OpenKNX/LED-UP1-6x24V/dev_doc/Pictures/IMG_20210327_100527976.jpg

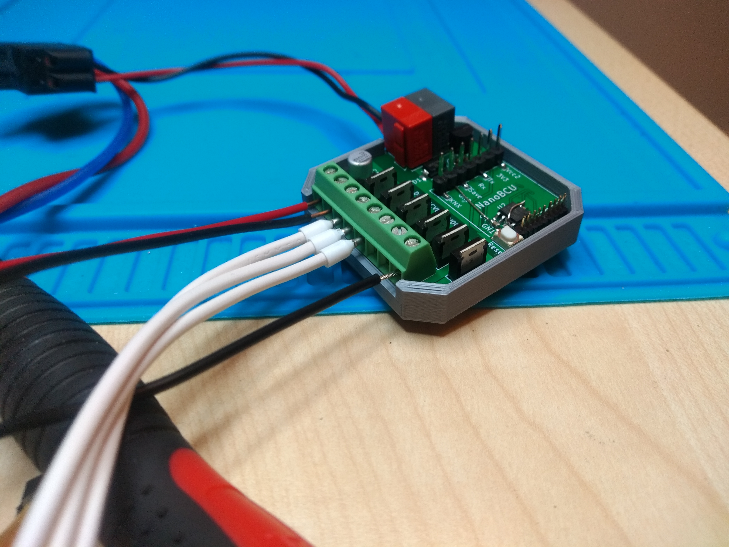
dev_doc/Pictures/IMG_20210327_100527976.jpg
