OpenKNX/LED-UP1-6x24V/dev_doc/Pictures/IMG_20210327_111949214.jpg

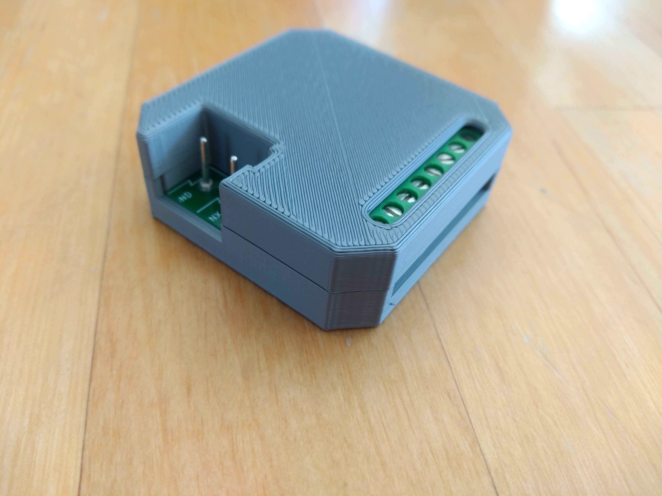
dev_doc/Pictures/IMG_20210327_111949214.jpg
