OpenKNX/LED-UP1-6x24V/README.md

# LED-UP1-6x24V
OpenKNX 6channel LED PWM Controller up to 24V

see https://github.com/OpenKNX/OpenKNX/wiki/LED-UP1-6x24V
