OpenKNX/LED-UP1-6x24V/dev_doc/2022-01-28 14_53_08-3D Viewer.png

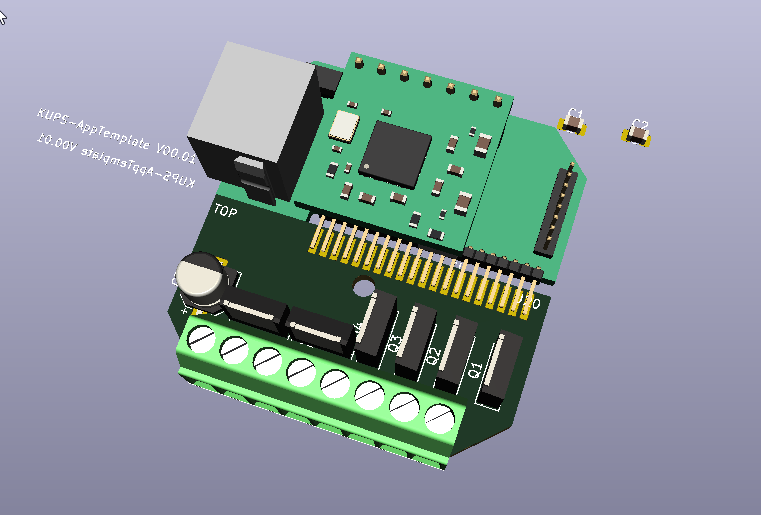
dev_doc/2022-01-28 14_53_08-3D Viewer.png
