OpenKNX/LED-UP1-6x24V/dev_doc/2022-01-29 09_12_00-3D Viewer.png

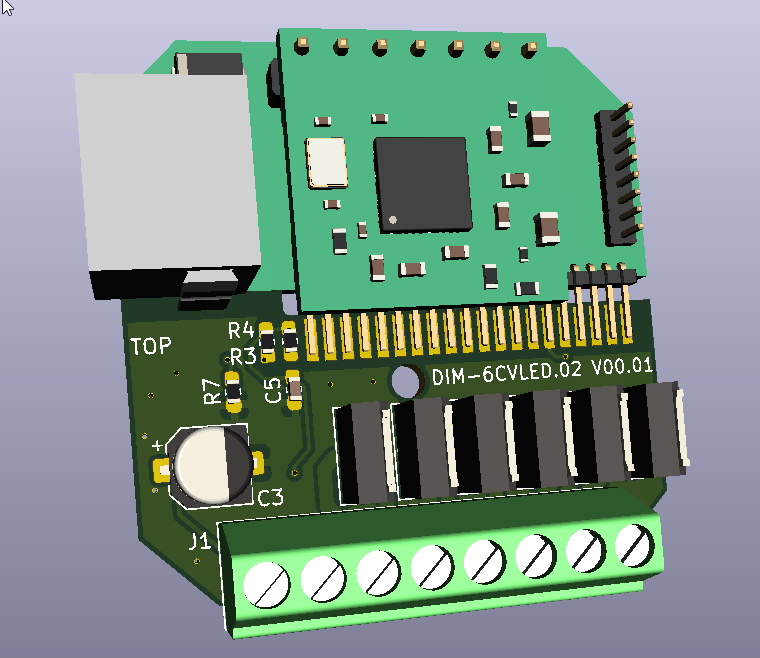
dev_doc/2022-01-29 09_12_00-3D Viewer.png
