OpenKNX/LED-UP1-6x24V/dev_doc/Pictures/IMG_20210327_100537087.jpg

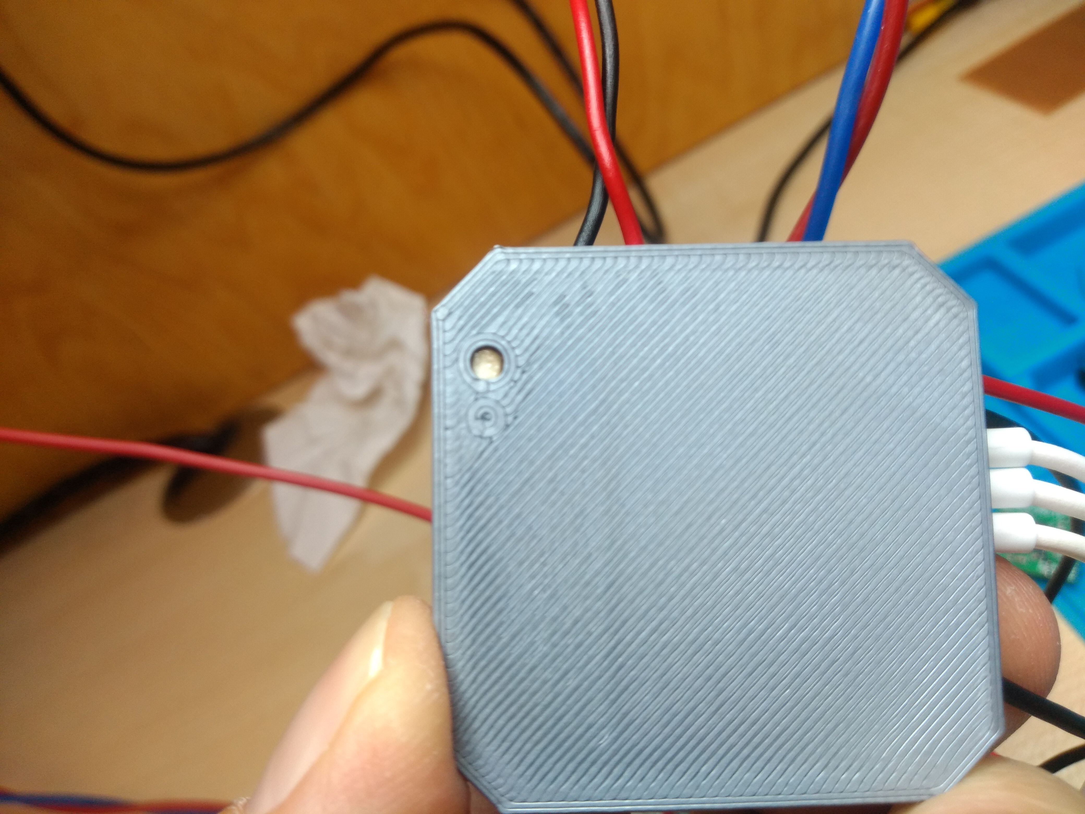
dev_doc/Pictures/IMG_20210327_100537087.jpg
