OpenKNX/LED-UP1-6x24V/dev_doc/Pictures/IMG_20210327_112004446.jpg

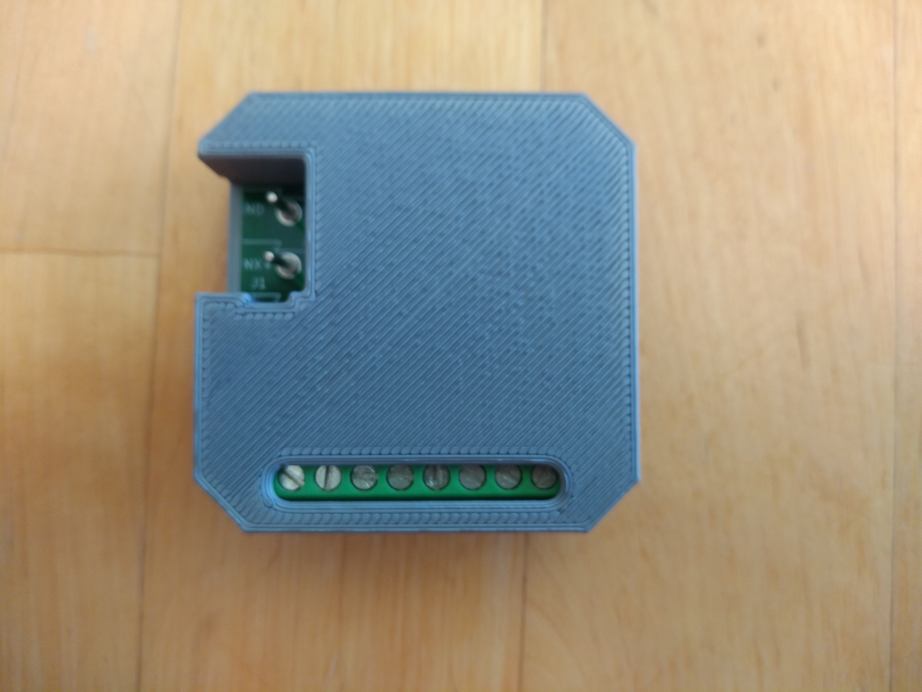
dev_doc/Pictures/IMG_20210327_112004446.jpg
