OpenKNX/LED-UP1-6x24V/dev_doc/Pictures/IMG_20210409_113622945.jpg

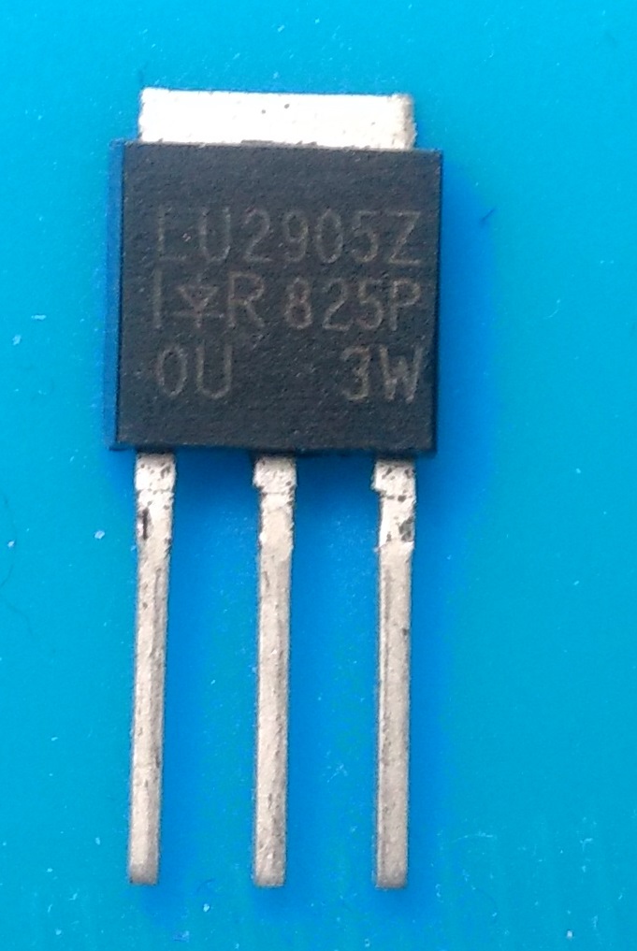
dev_doc/Pictures/IMG_20210409_113622945.jpg
