OpenKNX/LED-UP1-6x24V/dev_doc/Pictures/IMG_20210409_114843374.jpg

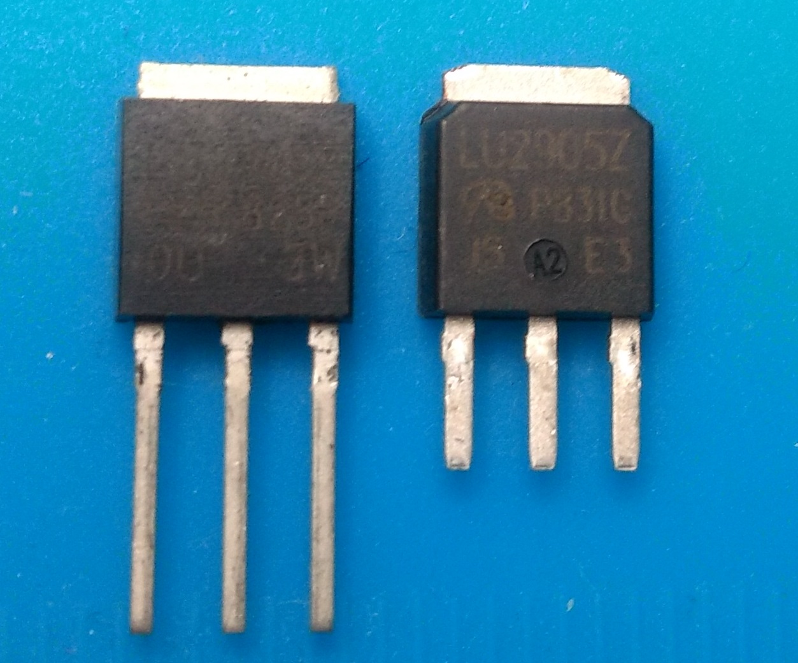
dev_doc/Pictures/IMG_20210409_114843374.jpg
