OpenKNX/LED-UP1-6x24V/dev_doc/Pictures/IMG_20210409_122635340.jpg

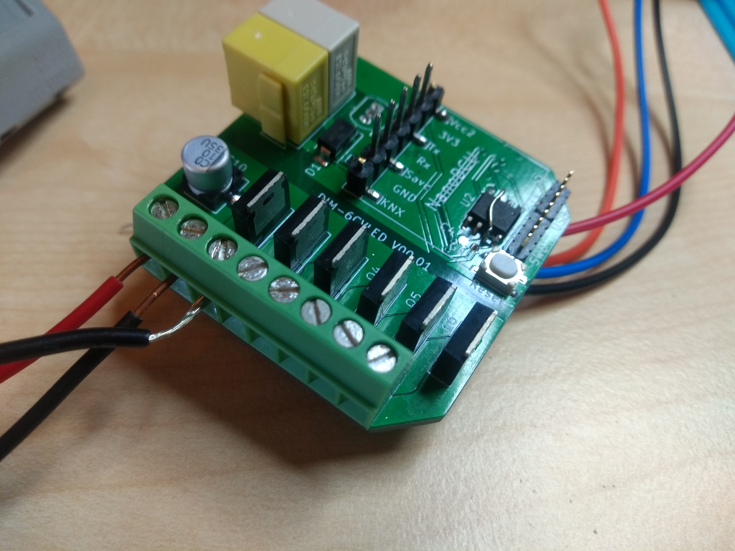
dev_doc/Pictures/IMG_20210409_122635340.jpg
