OpenKNX/LED-UP1-6x24V/dev_doc/Pictures/IMG_20210409_122652850.jpg

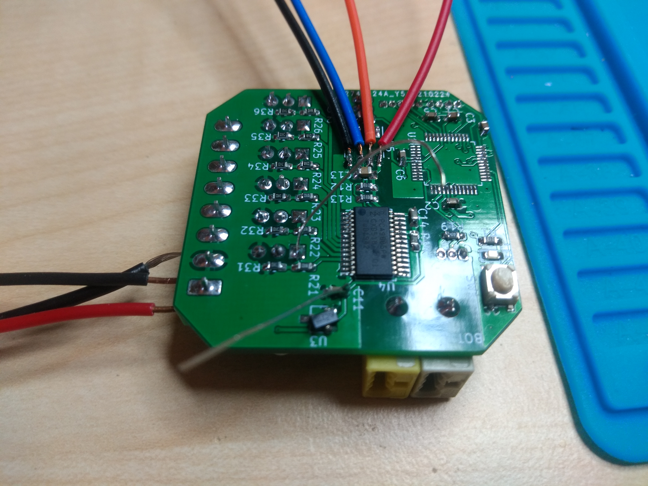
dev_doc/Pictures/IMG_20210409_122652850.jpg
