OpenKNX/LED-UP1-6x24V/dev_doc/Pictures/IMG_20210414_234219287.jpg

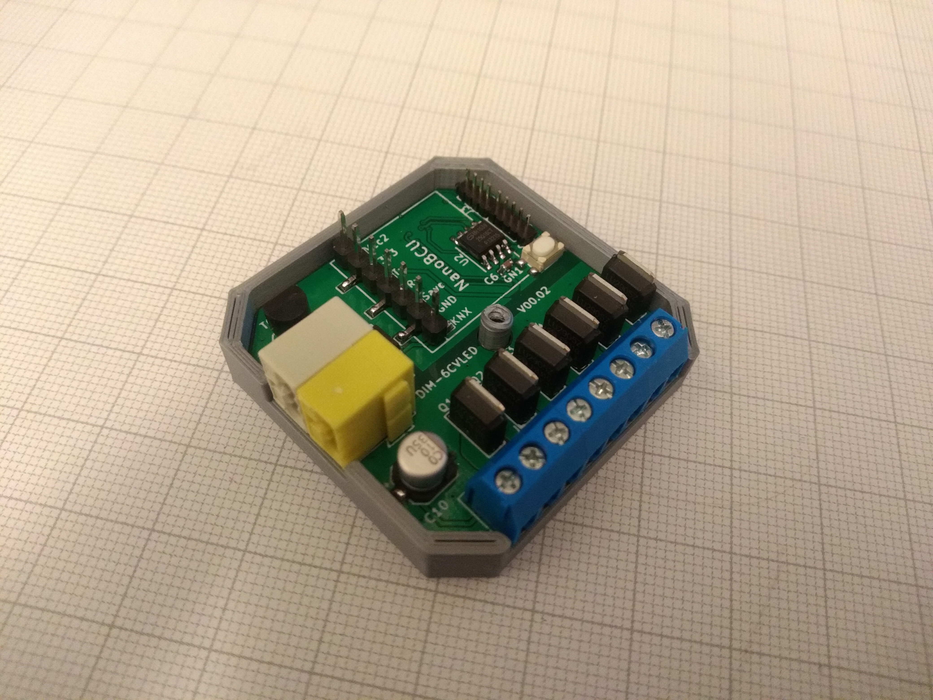
dev_doc/Pictures/IMG_20210414_234219287.jpg
