OpenKNX/LED-UP1-6x24V/dev_doc/Pictures/IMG_20210415_213555620.jpg

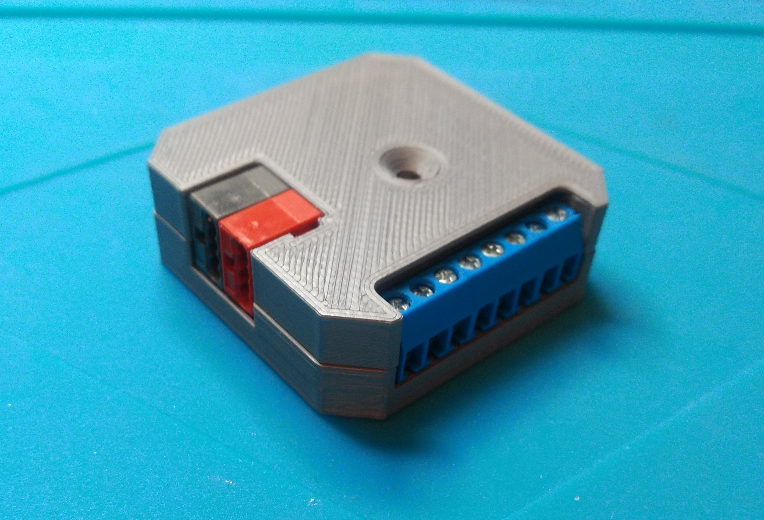
dev_doc/Pictures/IMG_20210415_213555620.jpg
