OpenKNX/LED-UP1-6x24V/dev_doc/Pictures/IMG_20210415_213606638.jpg

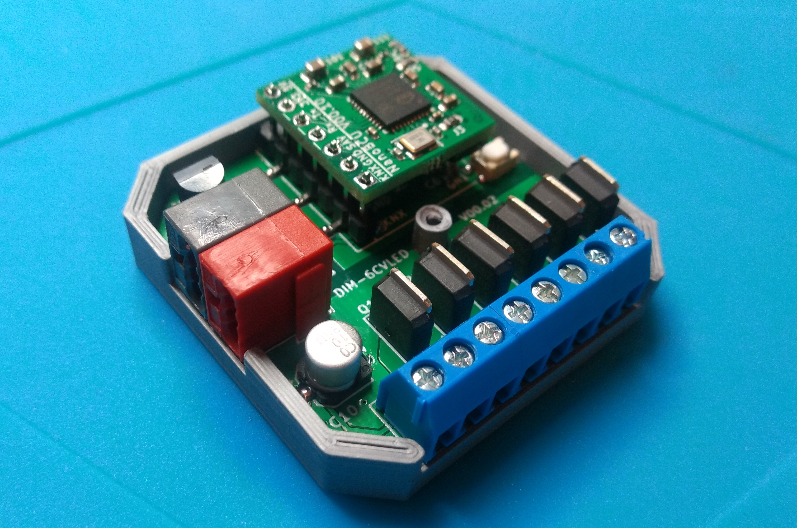
dev_doc/Pictures/IMG_20210415_213606638.jpg
