OpenKNX/LED-UP1-6x24V/dev_doc/Pictures/IMG_20210416_084224456.jpg

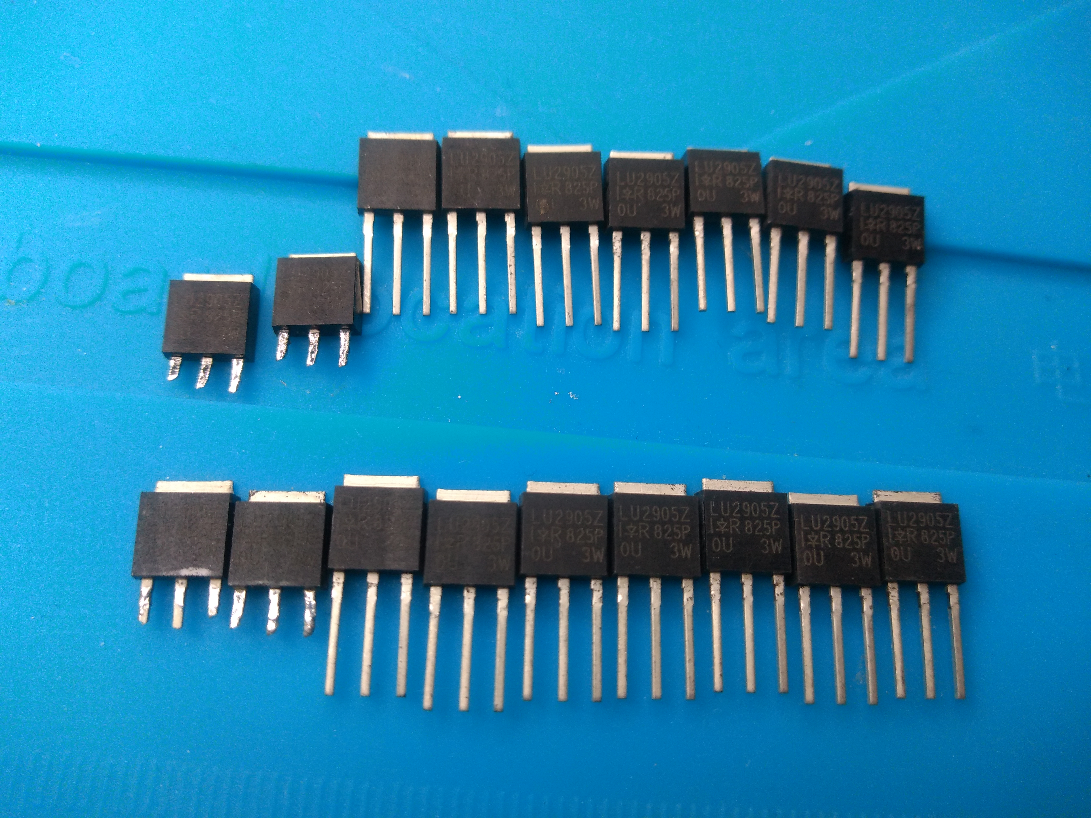
dev_doc/Pictures/IMG_20210416_084224456.jpg
