OpenKNX/LED-UP1-6x24V/dev_doc/Pictures/IMG_20210416_091842806.jpg

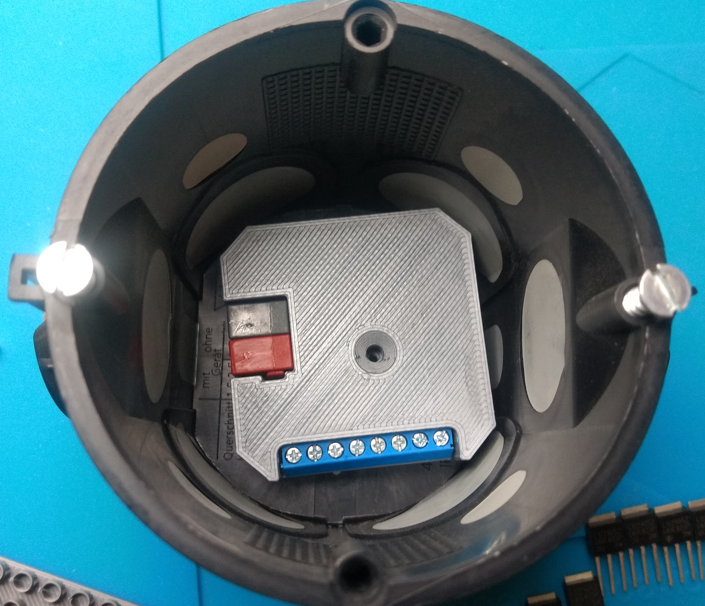
dev_doc/Pictures/IMG_20210416_091842806.jpg
