OpenKNX/LED-UP1-6x24V/doc/LED-UP1-6x24V_V00.11_PCB_bot.png

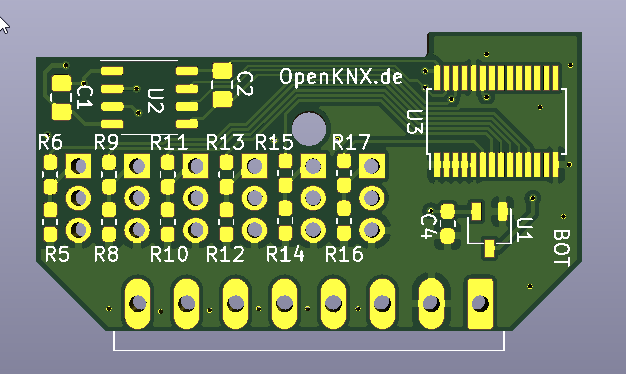
doc/LED-UP1-6x24V_V00.11_PCB_bot.png
