OpenKNX/LED-UP1-6x24V/doc/LED-UP1-6x24V_V00.11_PCB_top.png

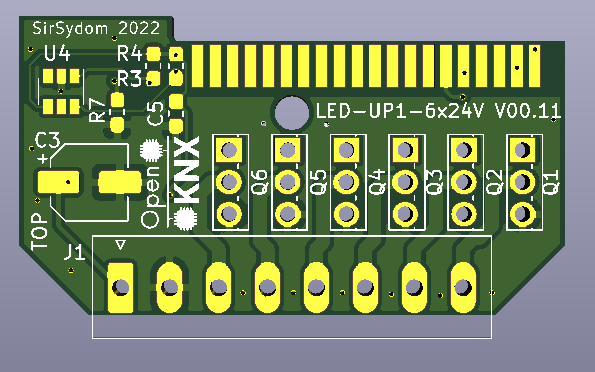
doc/LED-UP1-6x24V_V00.11_PCB_top.png
