OpenKNX/LED-UP1-6x24V/hardware/EDA-Files/KUPS-DIM-6CVLED - SAMD21/KUPS-DIM-6CVLED_BOM.xlsx

Sheet: KUPS-DIM-6CVLED
Id | Designator | Package | Quantity | Designation | Supplier and ref
1 | U4 | TSSOP-28_4.4x9.7mm_P0.65mm_Handsolder | 1 | PCA9685PW
2 | C14,C11 | C_0603_1608Metric_Pad1.05x0.95mm_HandSolder | 2 | 10uF
3 | R19 | R_0603_1608Metric_Pad1.05x0.95mm_HandSolder | 1 | 4k7
4 | C10 | CP_Elec_5x5.3 | 1 | 10uF / 35V
5 | U6 | TO-92_Inline | 1 | DS18B20
6 | R31,R32,R36,R35,R34,R33,R14 | R_0603_1608Metric_Pad1.05x0.95mm_HandSolder | 7 | 10k
7 | R21,R22,R26,R24,R23,R25 | R_0603_1608Metric_Pad1.05x0.95mm_HandSolder | 6 | 100R
8 | Q1,Q2,Q6,Q4,Q3,Q5 | TO-251-3_Vertical | 6 | IRLU2905
9 | J4 | PhoenixContact_MKDS_1,5_8-G-3.5_1x08_P3.5mm_Horizontal | 1 | Conn_01x08
10 | C13,C12 | C_0805_2012Metric_Pad1.15x1.40mm_HandSolder | 2 | 47nF
11 | GN1 | NanoBCU_PinHeader_SMD_low_profile | 1 | Konnekting_ÂµBCU
12 | U5 | SOIC-8_3.9x4.9mm_P1.27mm | 1 | ADuM1250
13 | U3 | TSOT-23 | 1 | LDO 5V SOT23-3
14 | R13,R12,R11,R10 | R_0603_1608Metric_Pad1.05x0.95mm_HandSolder | 4 | 1k
15 | R1 | R_0603_1608Metric_Pad1.05x0.95mm_HandSolder | 1 | R
16 | J1 | KNX_Connector | 1 | KNX_Conn
17 | SW2 | SW_Push_Xunpu_TS-1089S | 1 | Reset
18 | U2 | SOIC-8_3.9x4.9mm_P1.27mm | 1 | GD25Q16C
19 | C6,C5,C3,C2,C1,C4 | C_0603_1608Metric | 6 | 1ÂµF
20 | U1 | TQFP-48_7x7mm_P0.5mm | 1 | ATSAMD21G18
21 | J3 | PinHeader_1x04_P1.27mm_Vertical | 1 | USB
22 | J2 | PinHeader_1x04_P1.27mm_Vertical | 1 | SWD
23 | D1 | D_SMA | 1 | SMAJ40CA
24 | SW1 | SW_Push_Xunpu_TS-1089S | 1 | Prog
25 | LED1 | LED_0603_1608Metric | 1 | LED

Sheet: Order List
Id | Designator | Package | Designation | MPN | Supplier | Supplier ref | Value | Price | Quant | Alt | Alt | Alt
7 | R21 | R_0603_1608Metric_Pad1.05x0.95mm_HandSolder | 100R | 0603WAF1000T5E | JLCPCB - Basic | C22775 | 100R 1% 1/10W | 0.0019
7 | R22 | R_0603_1608Metric_Pad1.05x0.95mm_HandSolder | 100R | 0603WAF1000T5E | JLCPCB - Basic | C22775 | 100R 1% 1/10W | 0.0019
7 | R23 | R_0603_1608Metric_Pad1.05x0.95mm_HandSolder | 100R | 0603WAF1000T5E | JLCPCB - Basic | C22775 | 100R 1% 1/10W | 0.0019
7 | R24 | R_0603_1608Metric_Pad1.05x0.95mm_HandSolder | 100R | 0603WAF1000T5E | JLCPCB - Basic | C22775 | 100R 1% 1/10W | 0.0019
7 | R25 | R_0603_1608Metric_Pad1.05x0.95mm_HandSolder | 100R | 0603WAF1000T5E | JLCPCB - Basic | C22775 | 100R 1% 1/10W | 0.0019
7 | R26 | R_0603_1608Metric_Pad1.05x0.95mm_HandSolder | 100R | 0603WAF1000T5E | JLCPCB - Basic | C22775 | 100R 1% 1/10W | 0.0019
3 | R19 | R_0603_1608Metric_Pad1.05x0.95mm_HandSolder | 4k7 | 0603WAF4701T5E | JLCPCB - Basic | C23162 | 4k7 1% 1/10W | 0.0022
6 | R14 | R_0603_1608Metric_Pad1.05x0.95mm_HandSolder | 10k | 0603WAF1002T5E | JLCPCB - Basic | C25804 | 10k 1% 1/10W | 0.0025
6 | R31 | R_0603_1608Metric_Pad1.05x0.95mm_HandSolder | 10k | 0603WAF1002T5E | JLCPCB - Basic | C25804 | 10k 1% 1/10W | 0.0025
6 | R32 | R_0603_1608Metric_Pad1.05x0.95mm_HandSolder | 10k | 0603WAF1002T5E | JLCPCB - Basic | C25804 | 10k 1% 1/10W | 0.0025
6 | R33 | R_0603_1608Metric_Pad1.05x0.95mm_HandSolder | 10k | 0603WAF1002T5E | JLCPCB - Basic | C25804 | 10k 1% 1/10W | 0.0025
6 | R34 | R_0603_1608Metric_Pad1.05x0.95mm_HandSolder | 10k | 0603WAF1002T5E | JLCPCB - Basic | C25804 | 10k 1% 1/10W | 0.0025
6 | R35 | R_0603_1608Metric_Pad1.05x0.95mm_HandSolder | 10k | 0603WAF1002T5E | JLCPCB - Basic | C25804 | 10k 1% 1/10W | 0.0025
6 | R36 | R_0603_1608Metric_Pad1.05x0.95mm_HandSolder | 10k | 0603WAF1002T5E | JLCPCB - Basic | C25804 | 10k 1% 1/10W | 0.0025
15 | R1 | R_0603_1608Metric_Pad1.05x0.95mm_HandSolder | 1k | 0603WAF1001T5E | JLCPCB - Basic | C21190 | 1k 1% 1/10W | 0.003
14 | R10 | R_0603_1608Metric_Pad1.05x0.95mm_HandSolder | 1k | 0603WAF1001T5E | JLCPCB - Basic | C21190 | 1k 1% 1/10W | 0.003
14 | R11 | R_0603_1608Metric_Pad1.05x0.95mm_HandSolder | 1k | 0603WAF1001T5E | JLCPCB - Basic | C21190 | 1k 1% 1/10W | 0.003
14 | R12 | R_0603_1608Metric_Pad1.05x0.95mm_HandSolder | 1k | 0603WAF1001T5E | JLCPCB - Basic | C21190 | 1k 1% 1/10W | 0.003
14 | R13 | R_0603_1608Metric_Pad1.05x0.95mm_HandSolder | 1k | 0603WAF1001T5E | JLCPCB - Basic | C21190 | 1k 1% 1/10W | 0.003
25 | LED1 | LED_0603_1608Metric | LED | KT-0603R | JLCPCB - Basic | C2286 |  | 0.0078
19 | C1 | C_0603_1608Metric | 1uF | CL10A105KB8NNNC | JLCPCB - Basic | C15849 | 1uF / 50V | 0.0126
19 | C2 | C_0603_1608Metric | 1uF | CL10A105KB8NNNC | JLCPCB - Basic | C15849 | 1uF / 50V | 0.0126
19 | C3 | C_0603_1608Metric | 1uF | CL10A105KB8NNNC | JLCPCB - Basic | C15849 | 1uF / 50V | 0.0126
19 | C4 | C_0603_1608Metric | 1uF | CL10A105KB8NNNC | JLCPCB - Basic | C15849 | 1uF / 50V | 0.0126
19 | C5 | C_0603_1608Metric | 1uF | CL10A105KB8NNNC | JLCPCB - Basic | C15849 | 1uF / 50V | 0.0126
19 | C6 | C_0603_1608Metric | 1uF | CL10A105KB8NNNC | JLCPCB - Basic | C15849 | 1uF / 50V | 0.0126
10 | C12 | C_0805_2012Metric_Pad1.15x1.40mm_HandSolder | 47nF | CL21B473KBCNNNC | JLCPCB - Basic | C53134 | 47nF / 50V | 0.0139
10 | C13 | C_0805_2012Metric_Pad1.15x1.40mm_HandSolder | 47nF | CL21B473KBCNNNC | JLCPCB - Basic | C53134 | 47nF / 50V | 0.0139
2 | C11 | C_0603_1608Metric_Pad1.05x0.95mm_HandSolder | 10uF / 6.3V | CL10A106KP8NNNC | JLCPCB - Basic | C19702 | 10uF / 10V | 0.0167
2 | C14 | C_0603_1608Metric_Pad1.05x0.95mm_HandSolder | 10uF / 6.3V | CL10A106KP8NNNC | JLCPCB - Basic | C19702 | 10uF / 10V | 0.0167
23 | D1 | D_SMA | SMAJ40CA | C113970 | JLCPCB - Ext | C113970 |  | 0.043
24 | SW1 | SW_Push_Xunpu_TS-1089S | Prog | TS-1089S-02526 | JLCPCB - Ext | C455282 |  | 0.047
17 | SW2 | SW_Push_Xunpu_TS-1089S | Reset | TS-1089S-02526 | JLCPCB - Ext | C455282 |  | 0.047
16 | J1 | KNX_Connector | KNX_Conn | WAGO 243-131 | Reichelt | WAGO 243-131 |  | 0.06 | 2
4 | C10 | CP_Elec_5x5.3 | 10uF / 35V | VEU100M1VTR-0506 | LCSC | C249728 | 10uF20% 35V 5x5.8mm 3000h | 0.065
22 | J2 | PinHeader_1x07_P1.27mm_Vertical | SWD | C124352 | LCSC | C124352 |  | 0.09 | 0.5
11 | GN1 | NanoBCU_PinHeader_SMD_low_profile | SMD Pinheader 1x07 2.54 |  | Aliexpress / ebay |  |  | 0.1
13 | U3 | TSOT-23 | LDO 5V SOT23-3 | ME6203A50M3G | JLCPCB - Ext | C92717 |  | 0.11
8 | Q1 | TO-251-3_Vertical | IRLU2905Z | IRLU2905Z | Aliexpress / ebay |  | 55V 42A 13mOhm | 0.5
8 | Q2 | TO-251-3_Vertical | IRLU2905Z | IRLU2905Z | Aliexpress / ebay |  | 55V 42A 13mOhm | 0.5
8 | Q3 | TO-251-3_Vertical | IRLU2905Z | IRLU2905Z | Aliexpress / ebay |  | 55V 42A 13mOhm | 0.5
8 | Q4 | TO-251-3_Vertical | IRLU2905Z | IRLU2905Z | Aliexpress / ebay |  | 55V 42A 13mOhm | 0.5
8 | Q5 | TO-251-3_Vertical | IRLU2905Z | IRLU2905Z | Aliexpress / ebay |  | 55V 42A 13mOhm | 0.5
8 | Q6 | TO-251-3_Vertical | IRLU2905Z | IRLU2905Z | Aliexpress / ebay |  | 55V 42A 13mOhm | 0.5
18 | U2 | SOIC-8_3.9x4.9mm_P1.27mm | GD25Q16C | GD25Q16CTIGR | LCSC | C395483 |  | 0.76
9 | J4 | PhoenixContact_MKDS_1,5_8-G-3.5_1x08_P3.5mm_Horizontal | Conn_01x08 | 310591-08 | Reichelt | AKL 059-08 |  | 0.99 |  | Digikey | 1751303 | 277-5792-ND
5 | U6 | TO-92_Inline | DS18B20 | DS18B20+ | LCSC | C9753 |  | 1.35 |  | LCSC | C376006 | 0.80USD
12 | U5 | SOIC-8_3.9x4.9mm_P1.27mm | ADuM1250 | ADUM1250ARZ-RL7 | JLCPCB - Ext | C13839 |  | 1.82
1 | U4 | TSSOP-28_4.4x9.7mm_P0.65mm_Handsolder | PCA9685PW | PCA9685PW | Digikey | 568-11925-1-ND |  | 2
20 | U1 | TQFP-48_7x7mm_P0.5mm | ATSAMD21G18 | ATSAMD21G18A-AU | Digikey | ATSAMD21G18A-AU-ND |  | 2.9
11 | GN1 | NanoBCU_PinHeader_SMD_low_profile | NanoBCU |  | KNX Makerstuff | 0010 |  | 4.5
 |  |  |  |  |  |  |  | 18.0727
