OpenKNX/LED-UP1-6x24V/doc/LED-UP1-6x24V_V00.11.stl

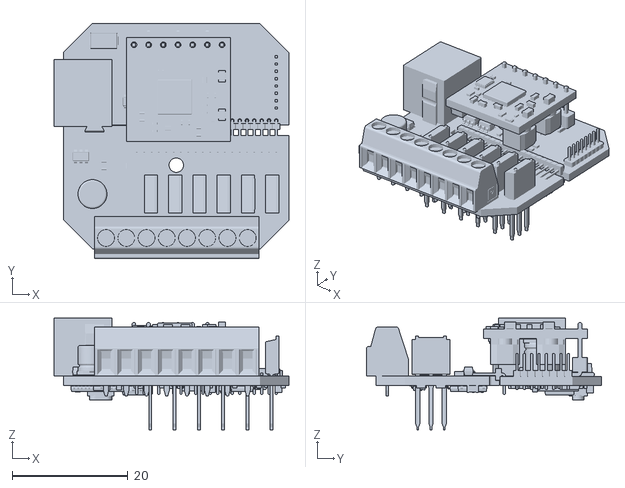
[picture p28: CAD file, 2022-02-16]
doc/LED-UP1-6x24V_V00.11.stl
40.7 x 40.7 x 19.4
