OpenKNX/LED-UP1-6x24V/hardware/CAD-Files/UP1-Case/LED-UP1-6x24V_Case_bot_001_panel1x3.stl

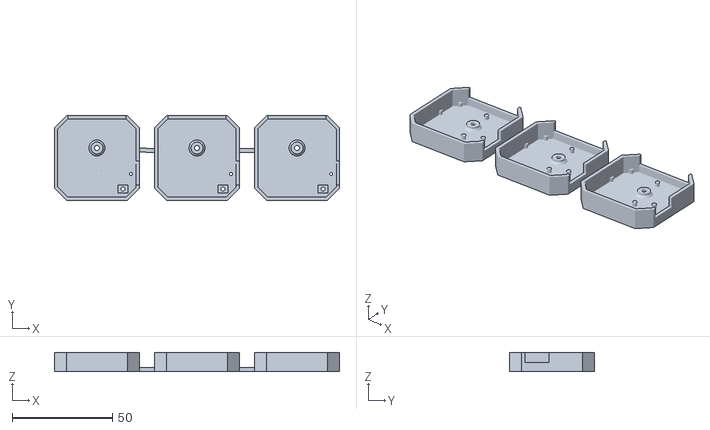
[picture p29: CAD file, 2023-12-05]
hardware/CAD-Files/UP1-Case/LED-UP1-6x24V_Case_bot_001_panel1x3.stl
142.4 x 42.4 x 9.60
