OpenKNX/LED-UP1-6x24V/hardware/CAD-Files/UP1-Case/LED-UP1-6x24V_Case_bot_001_panel2x5.stl

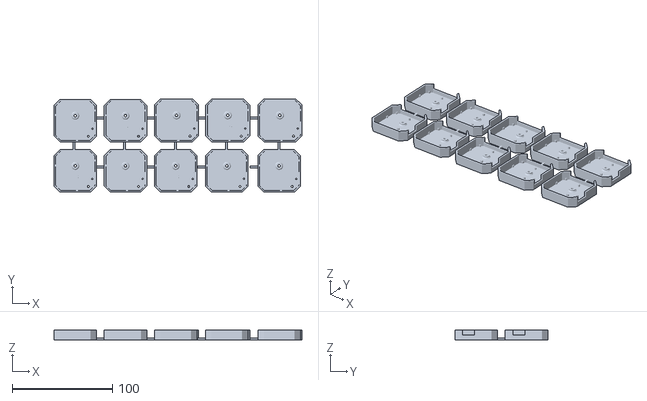
[picture p30: CAD file, 2023-12-05]
hardware/CAD-Files/UP1-Case/LED-UP1-6x24V_Case_bot_001_panel2x5.stl
247.0 x 93.0 x 9.60
