OpenKNX/LED-UP1-6x24V/hardware/CAD-Files/UP1-Case/LED-UP1-6x24V_Case_bot_001_panel2x3.stl

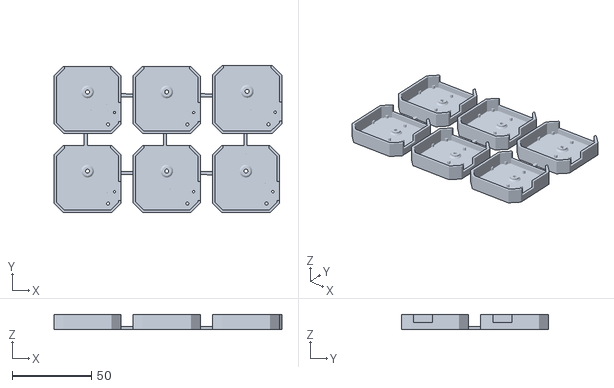
[picture p32: CAD file, 2022-10-12]
hardware/CAD-Files/UP1-Case/LED-UP1-6x24V_Case_bot_001_panel2x3.stl
144.0 x 93.0 x 9.60
