OpenKNX/LED-UP1-6x24V/hardware/CAD-Files/UP1-Case/LED-UP1-6x24V_Case_top_001_panel2x3.stl

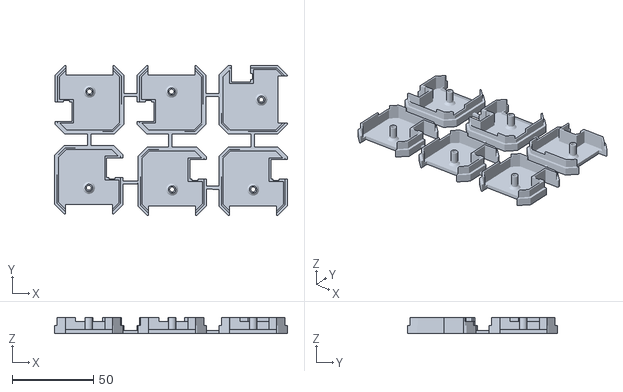
[picture p33: CAD file, 2022-10-12]
hardware/CAD-Files/UP1-Case/LED-UP1-6x24V_Case_top_001_panel2x3.stl
143.8 x 92.8 x 10.0
