OpenKNX/LED-UP1-6x24V/hardware/CAD-Files/UP1-Case/LED-UP1-6x24V_Case_top_001.stl

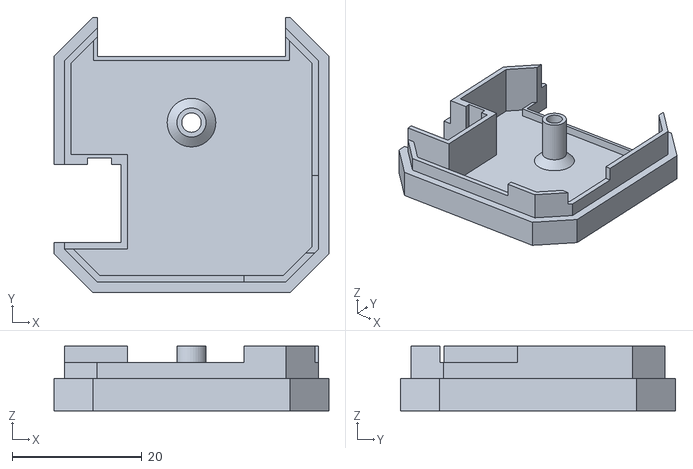
[picture p34: CAD file, 2022-10-12]
hardware/CAD-Files/UP1-Case/LED-UP1-6x24V_Case_top_001.stl
42.4 x 42.4 x 10.0
