OpenKNX/LED-UP1-6x24V/(list of files, cad)

Other CAD files:
hardware/CAD-Files/UP1-Case/LED-UP1-6x24V_Case_assembly_001.CATProduct
hardware/CAD-Files/UP1-Case/LED-UP1-6x24V_Case_bot_001.CATPart
hardware/CAD-Files/UP1-Case/LED-UP1-6x24V_Case_top_001.CATPart
hardware/CAD-Files/UP1-Case/PCB/C1_C_0805_2012Metric_61F44309.CATPart
hardware/CAD-Files/UP1-Case/PCB/C2_C_0805_2012Metric_61F451E7.CATPart
hardware/CAD-Files/UP1-Case/PCB/C3_CP_Elec_5x53_61F4F693.CATPart
hardware/CAD-Files/UP1-Case/PCB/C4_C_0603_1608Metric_61F44353.CATPart
hardware/CAD-Files/UP1-Case/PCB/C5_C_0603_1608Metric_61F44364.CATPart
hardware/CAD-Files/UP1-Case/PCB/J1_pxc_1751303_04_MKDS-1-8-3-5_3D_61F44380.CATPart
hardware/CAD-Files/UP1-Case/PCB/LED-UP1-6x24V_V00.11.CATProduct
hardware/CAD-Files/UP1-Case/PCB/PCB_Sketch_5730.CATPart
hardware/CAD-Files/UP1-Case/PCB/Pcb_5730.CATPart
hardware/CAD-Files/UP1-Case/PCB/Q1_TO-251-3_Vertical_61F443C7.CATPart
hardware/CAD-Files/UP1-Case/PCB/Q2_TO-251-3_Vertical_61F443E0.CATPart
hardware/CAD-Files/UP1-Case/PCB/Q3_TO-251-3_Vertical_61F443F9.CATPart
hardware/CAD-Files/UP1-Case/PCB/Q4_TO-251-3_Vertical_61F44B8B.CATPart
hardware/CAD-Files/UP1-Case/PCB/Q5_TO-251-3_Vertical_61F4871E.CATPart
hardware/CAD-Files/UP1-Case/PCB/Q6_TO-251-3_Vertical_61F486D6.CATPart
hardware/CAD-Files/UP1-Case/PCB/R10_R_0603_1608Metric_61F444EE.CATPart
hardware/CAD-Files/UP1-Case/PCB/R11_R_0603_1608Metric_61F444FF.CATPart
hardware/CAD-Files/UP1-Case/PCB/R12_R_0603_1608Metric_61F44510.CATPart
hardware/CAD-Files/UP1-Case/PCB/R13_R_0603_1608Metric_61F44521.CATPart
hardware/CAD-Files/UP1-Case/PCB/R14_R_0603_1608Metric_61F48770.CATPart
hardware/CAD-Files/UP1-Case/PCB/R15_R_0603_1608Metric_61F48800.CATPart
hardware/CAD-Files/UP1-Case/PCB/R16_R_0603_1608Metric_61F487D0.CATPart
hardware/CAD-Files/UP1-Case/PCB/R17_R_0603_1608Metric_61F487A0.CATPart
hardware/CAD-Files/UP1-Case/PCB/R3_R_0603_1608Metric_61F44477.CATPart
hardware/CAD-Files/UP1-Case/PCB/R4_R_0603_1608Metric_61F44488.CATPart
hardware/CAD-Files/UP1-Case/PCB/R5_R_0603_1608Metric_61F44499.CATPart
hardware/CAD-Files/UP1-Case/PCB/R6_R_0603_1608Metric_61F444AA.CATPart
hardware/CAD-Files/UP1-Case/PCB/R7_R_0603_1608Metric_61F444BB.CATPart
hardware/CAD-Files/UP1-Case/PCB/R8_R_0603_1608Metric_61F444CC.CATPart
hardware/CAD-Files/UP1-Case/PCB/R9_R_0603_1608Metric_61F444DD.CATPart
hardware/CAD-Files/UP1-Case/PCB/U1_TSOT_23_61F4457A.CATPart
hardware/CAD-Files/UP1-Case/PCB/U2_SSOP_8_39x505mm_P127mm_61F44595.CATPart
hardware/CAD-Files/UP1-Case/PCB/U3_TSSOP_28_44x97mm_P065mm_61F448E1.CATPart
hardware/CAD-Files/UP1-Case/PCB/U4_SOT_23_6_61F930D5.CATPart
