OpenKNX/LED-UP1-6x24V/hardware/EDA-Files/KUPS-DIM-6CVLED - SAMD21/KUPS-DIM-6CVLED_V00.03_Schematic.pdf

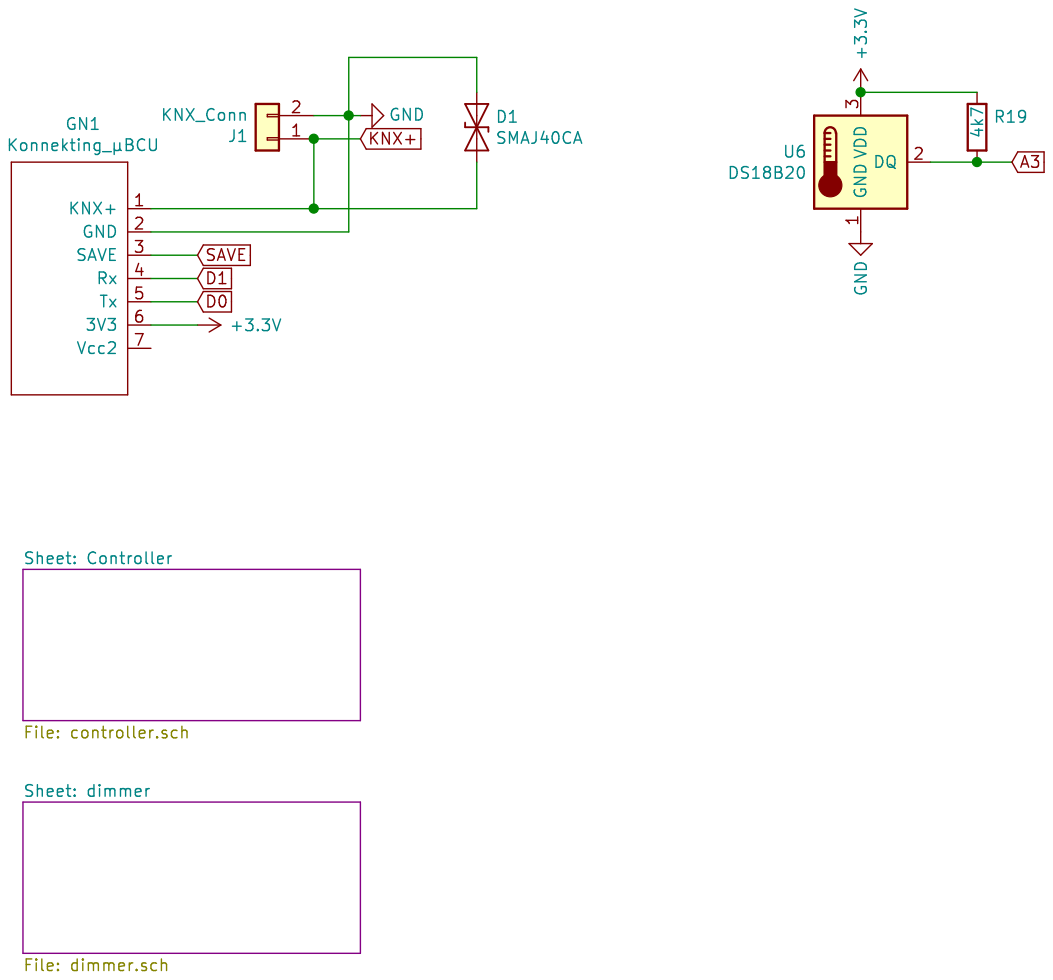
[picture p35: page 1]

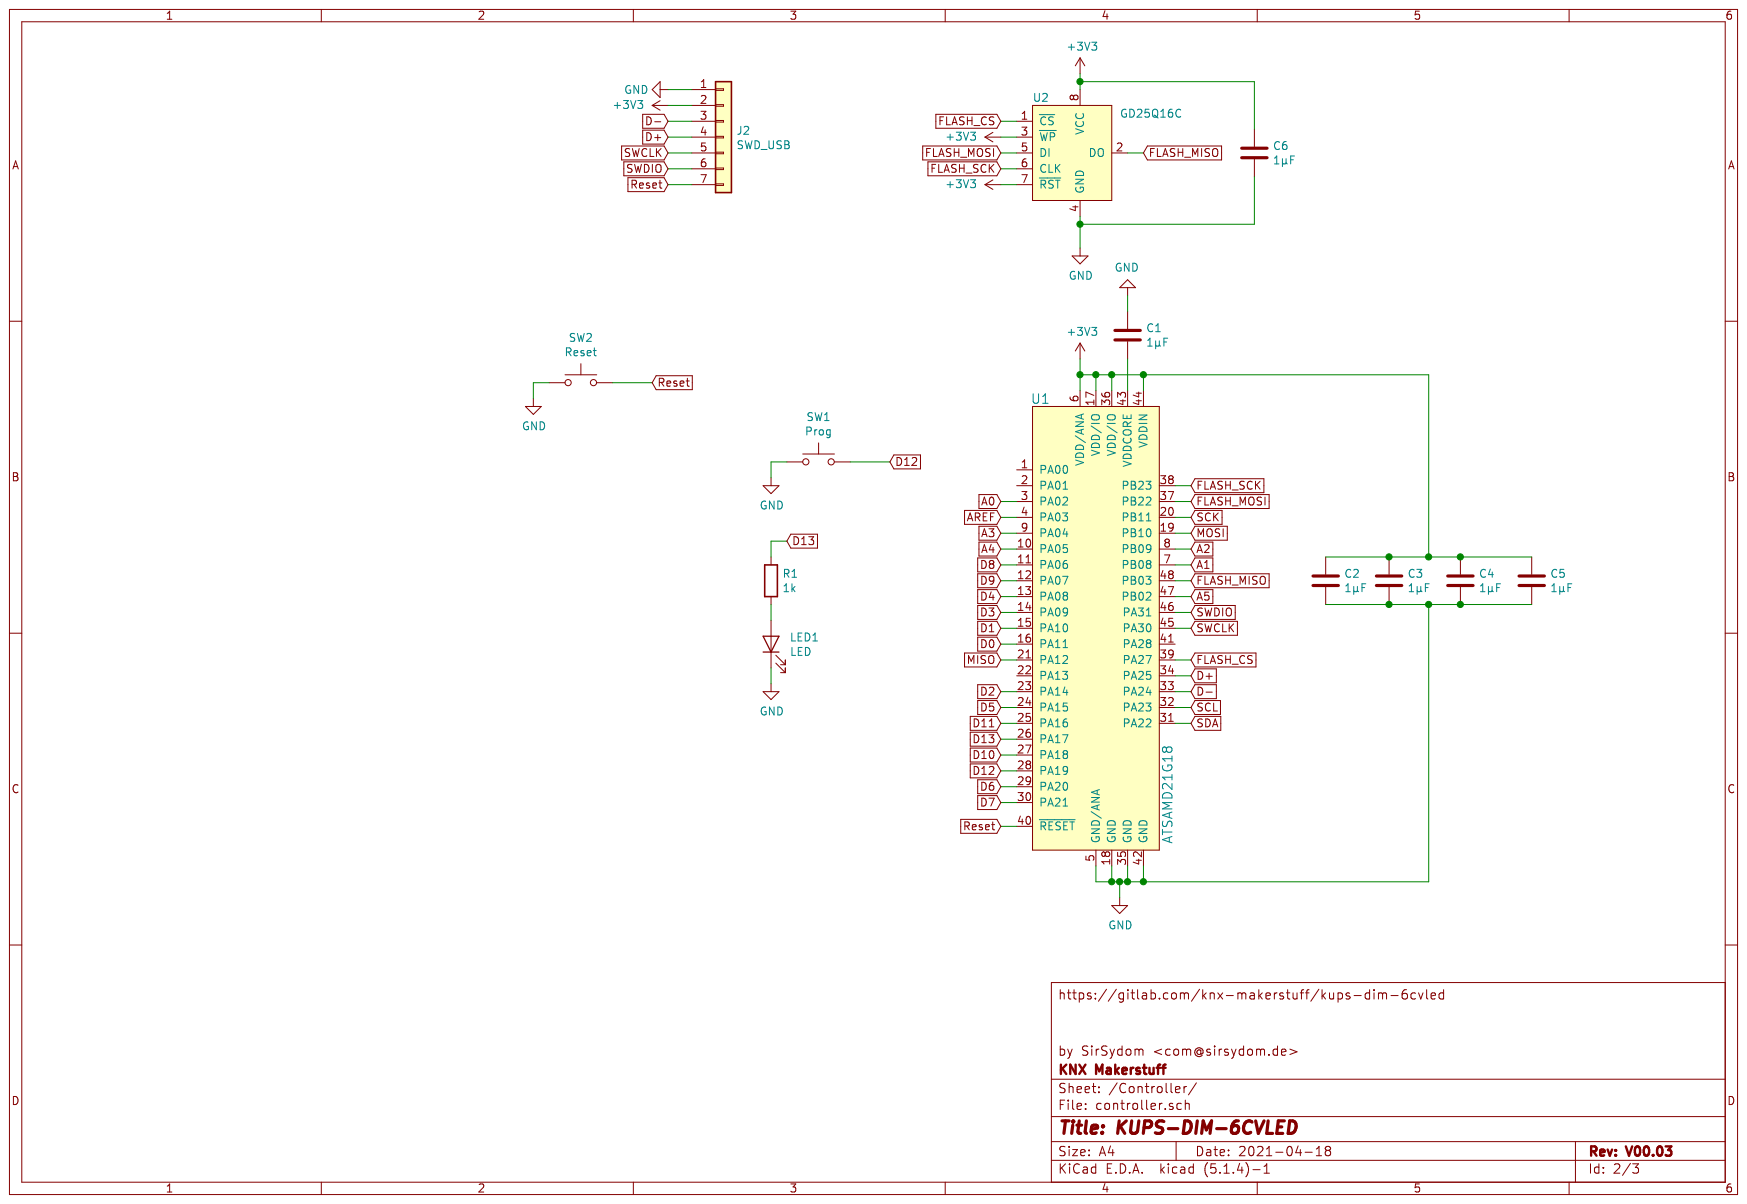
[picture p36: page 2]

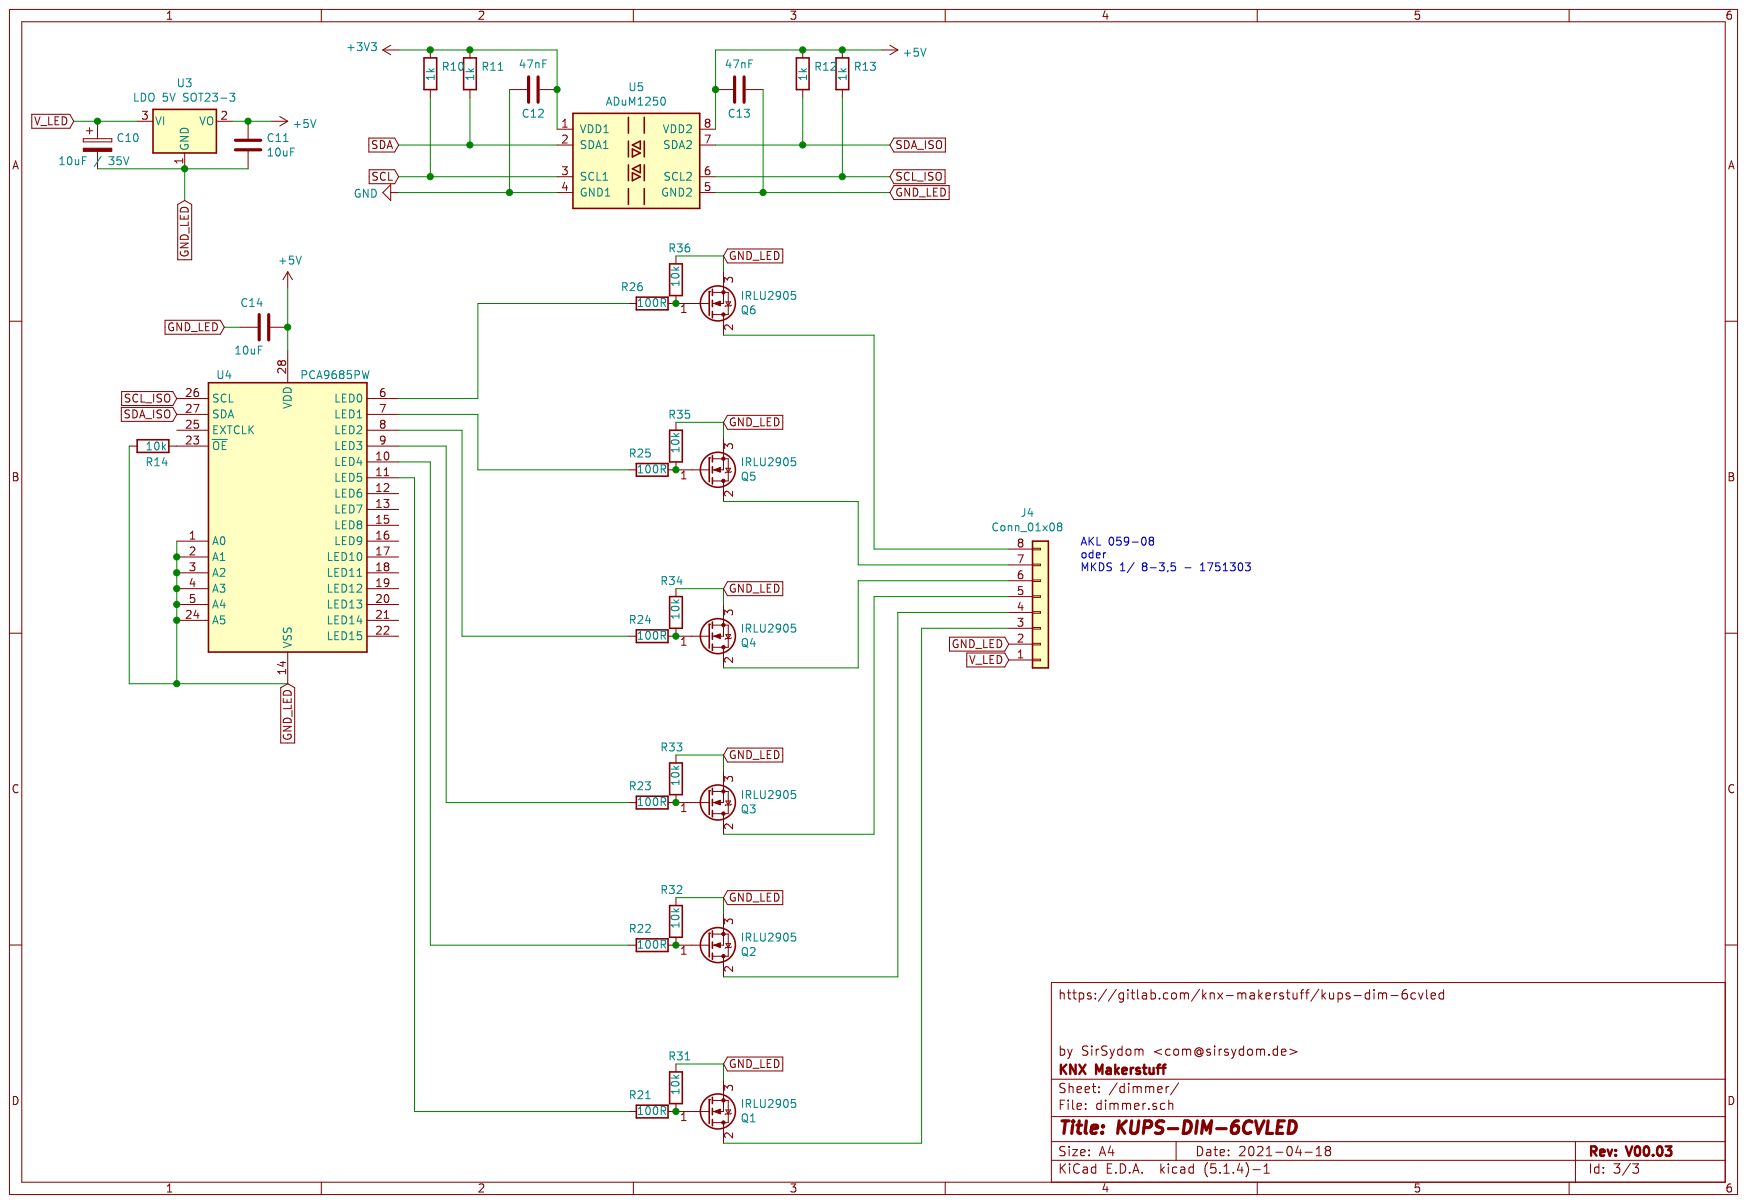
[picture p37: page 3]
