OpenKNX/LED-UP1-6x24V/doc/LED-UP1-6x24V_V00.11.sch.pdf

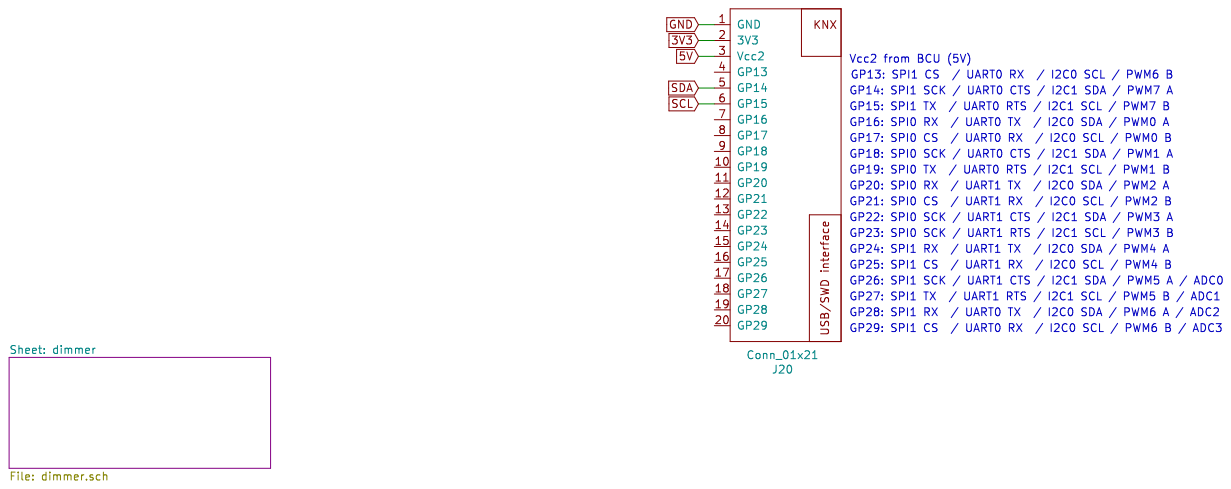
[picture p38: page 1]

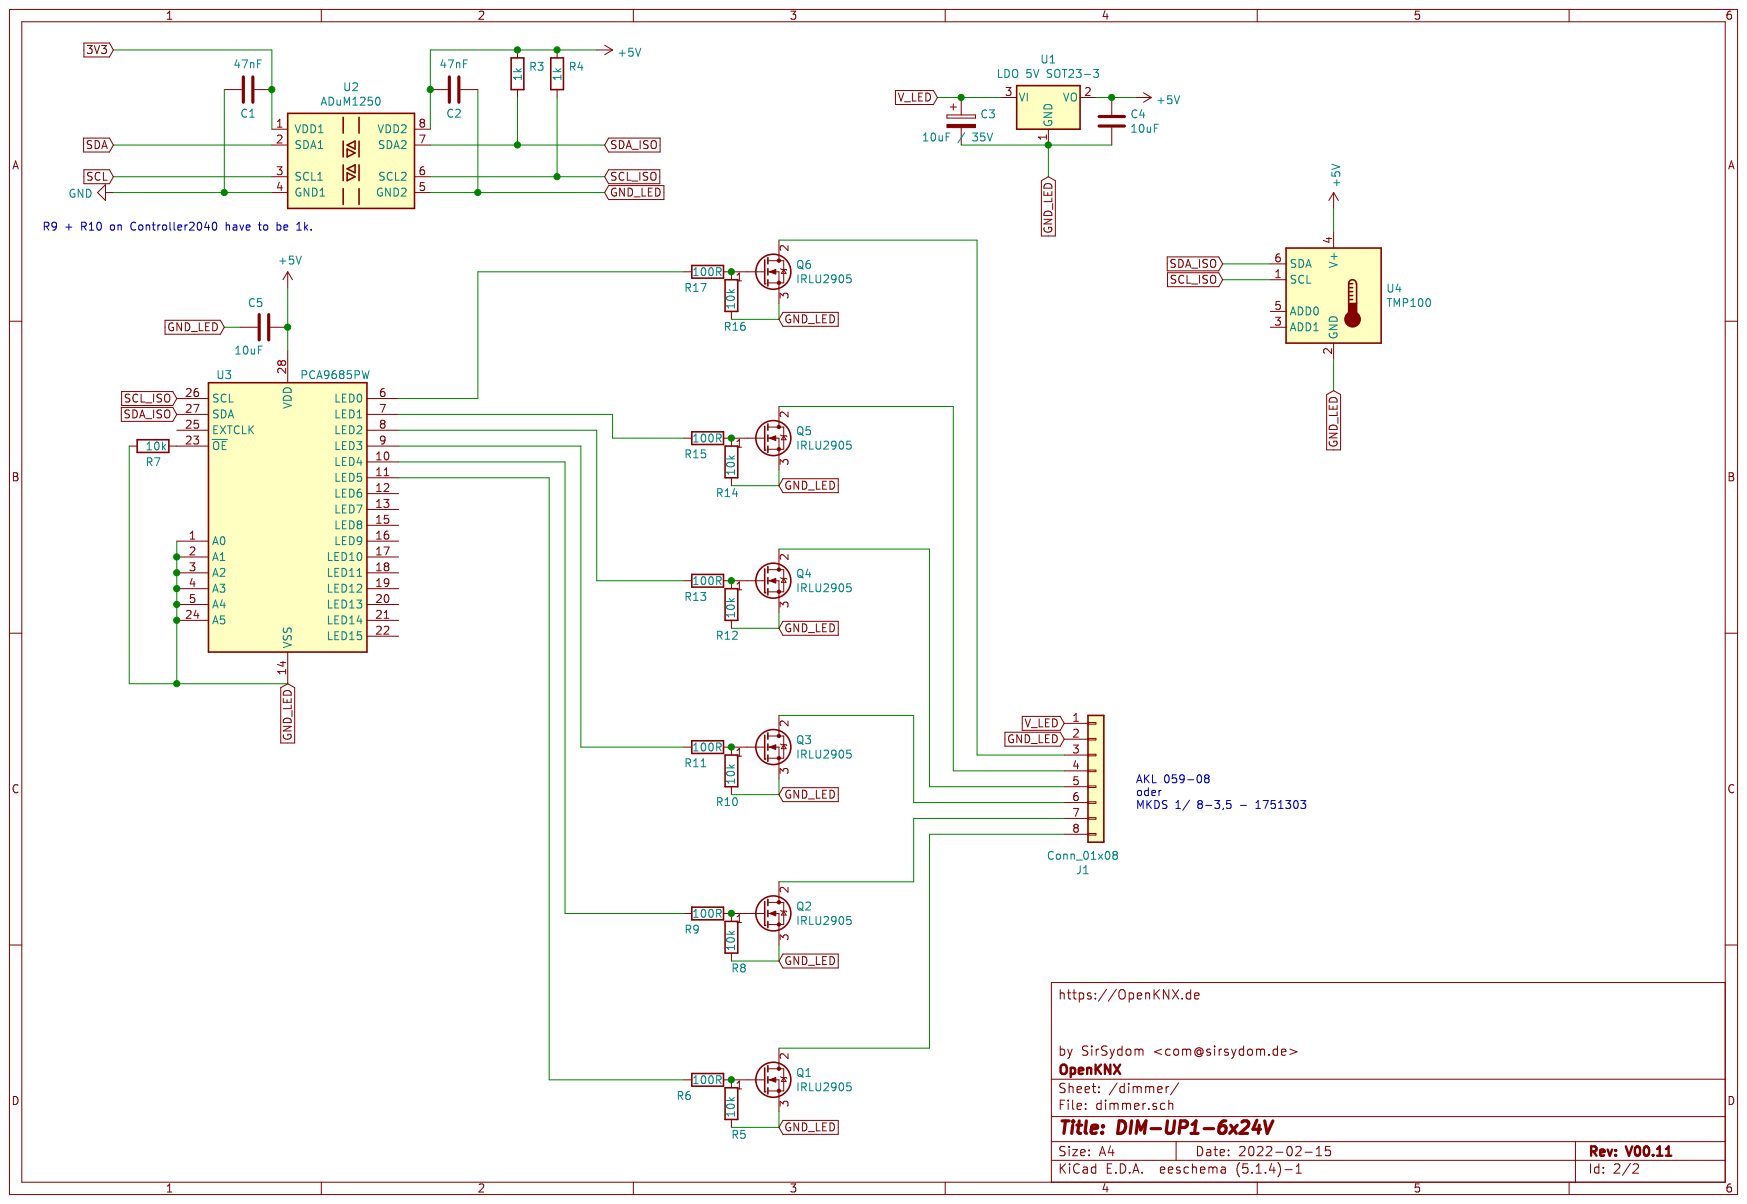
[picture p39: page 2]
