OpenKNX/LED-UP1-6x24V/hardware/EDA-Files/KUPS-DIM-6CVLED - SAMD21/KUPS-DIM-6CVLED_V00.01_Schematic.pdf

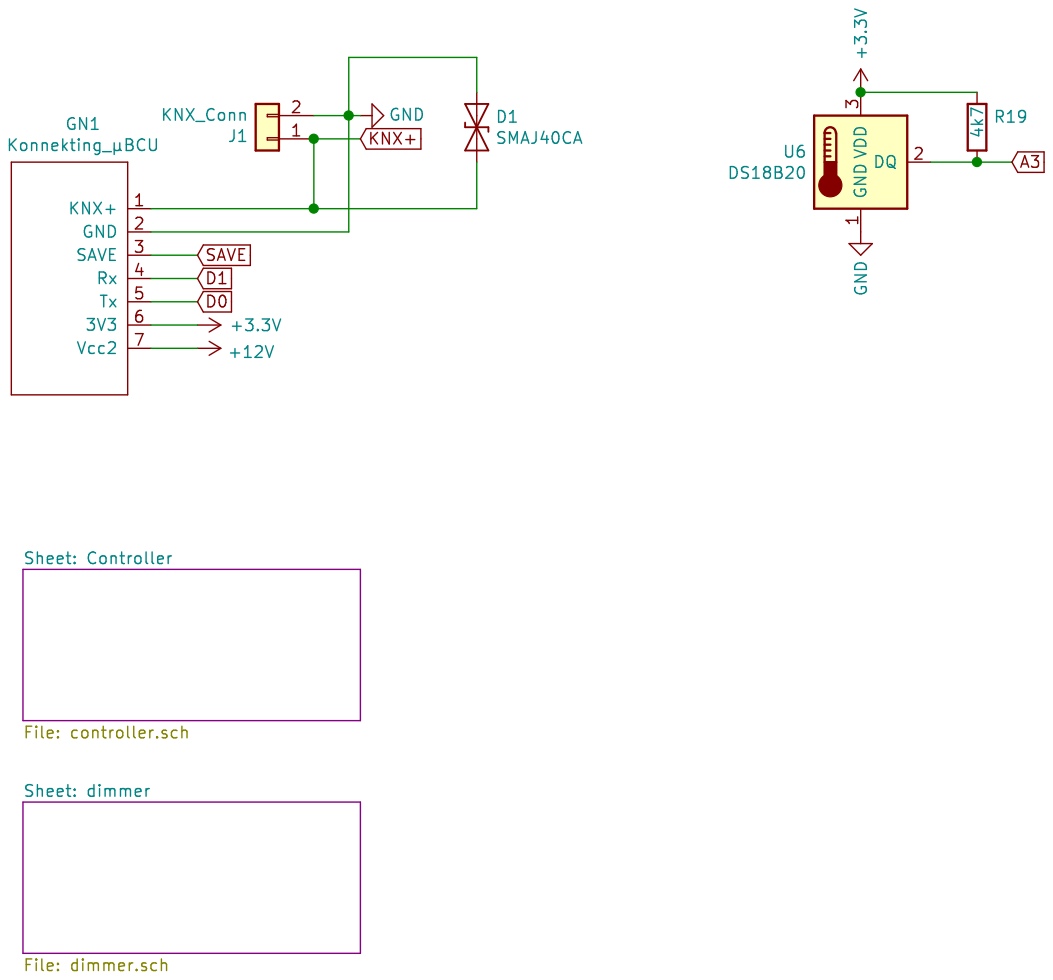
[picture p40: page 1]

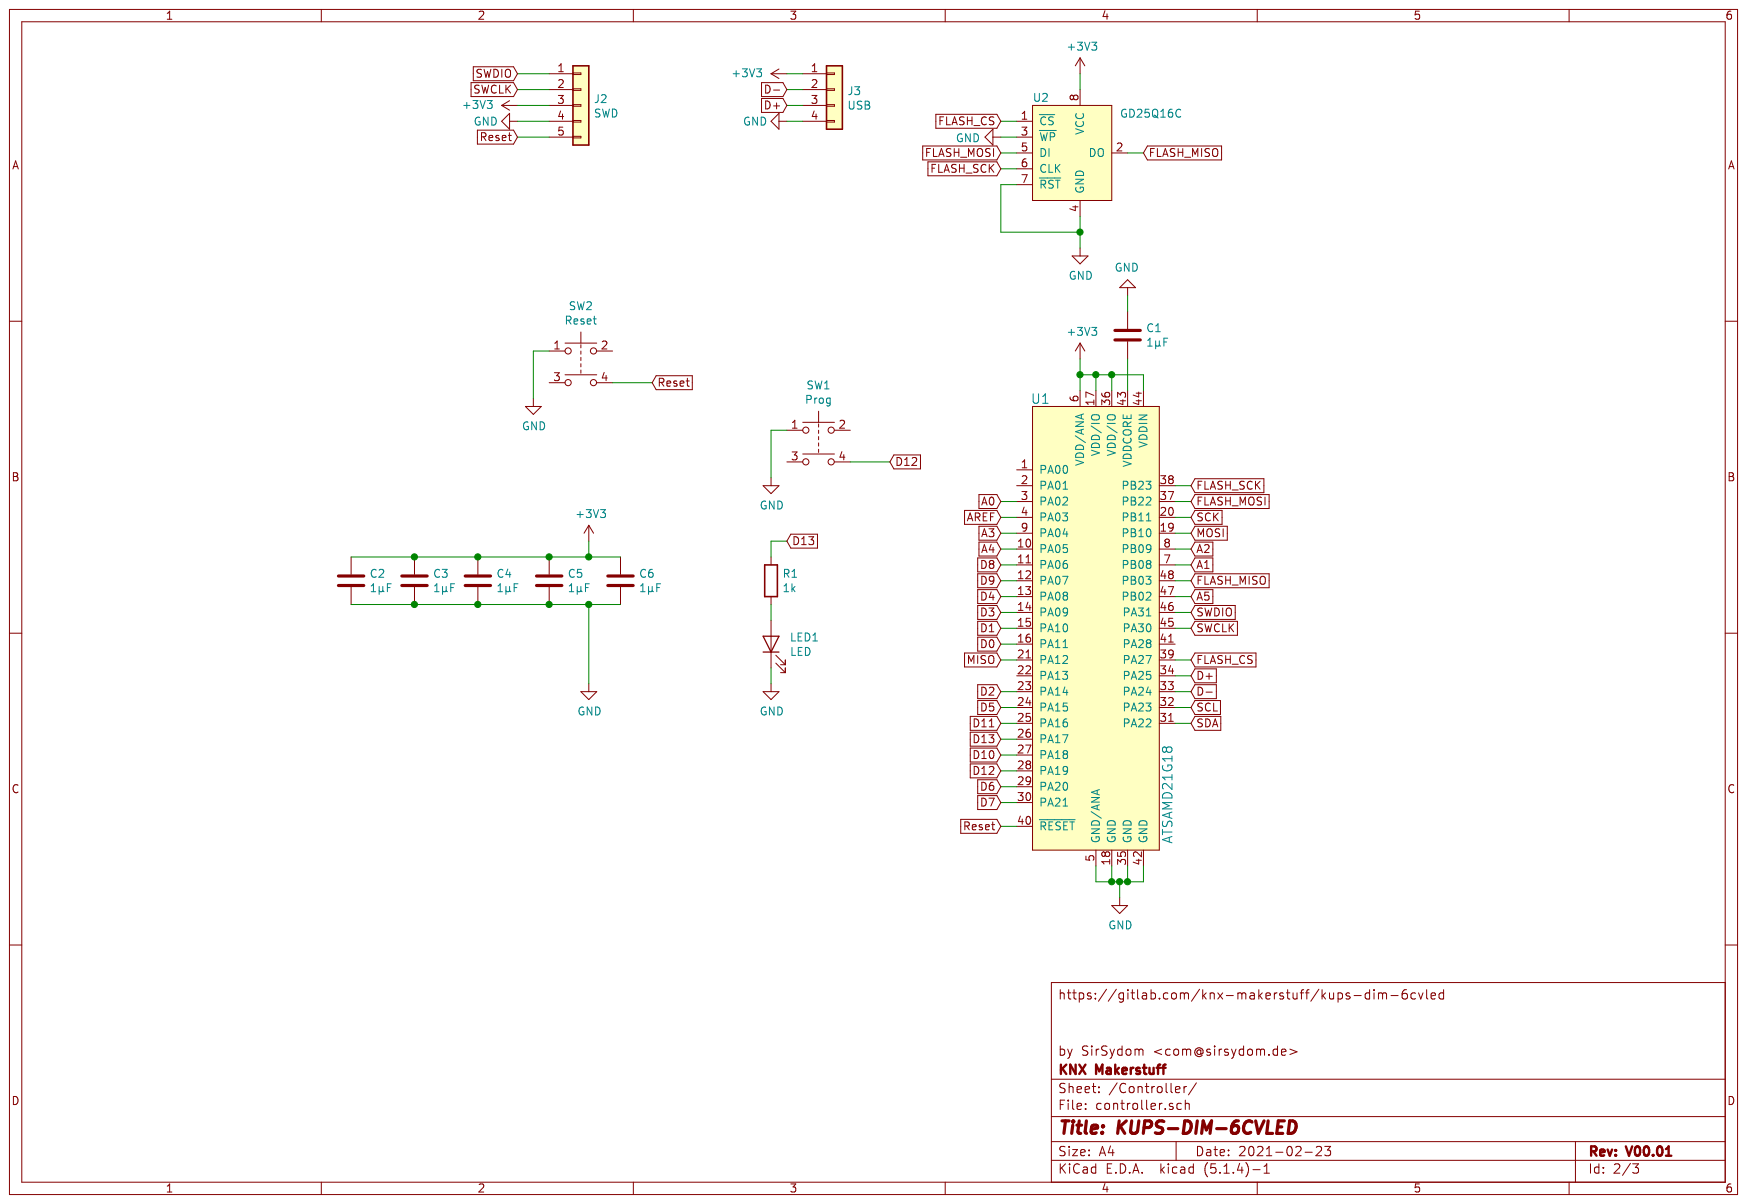
[picture p41: page 2]

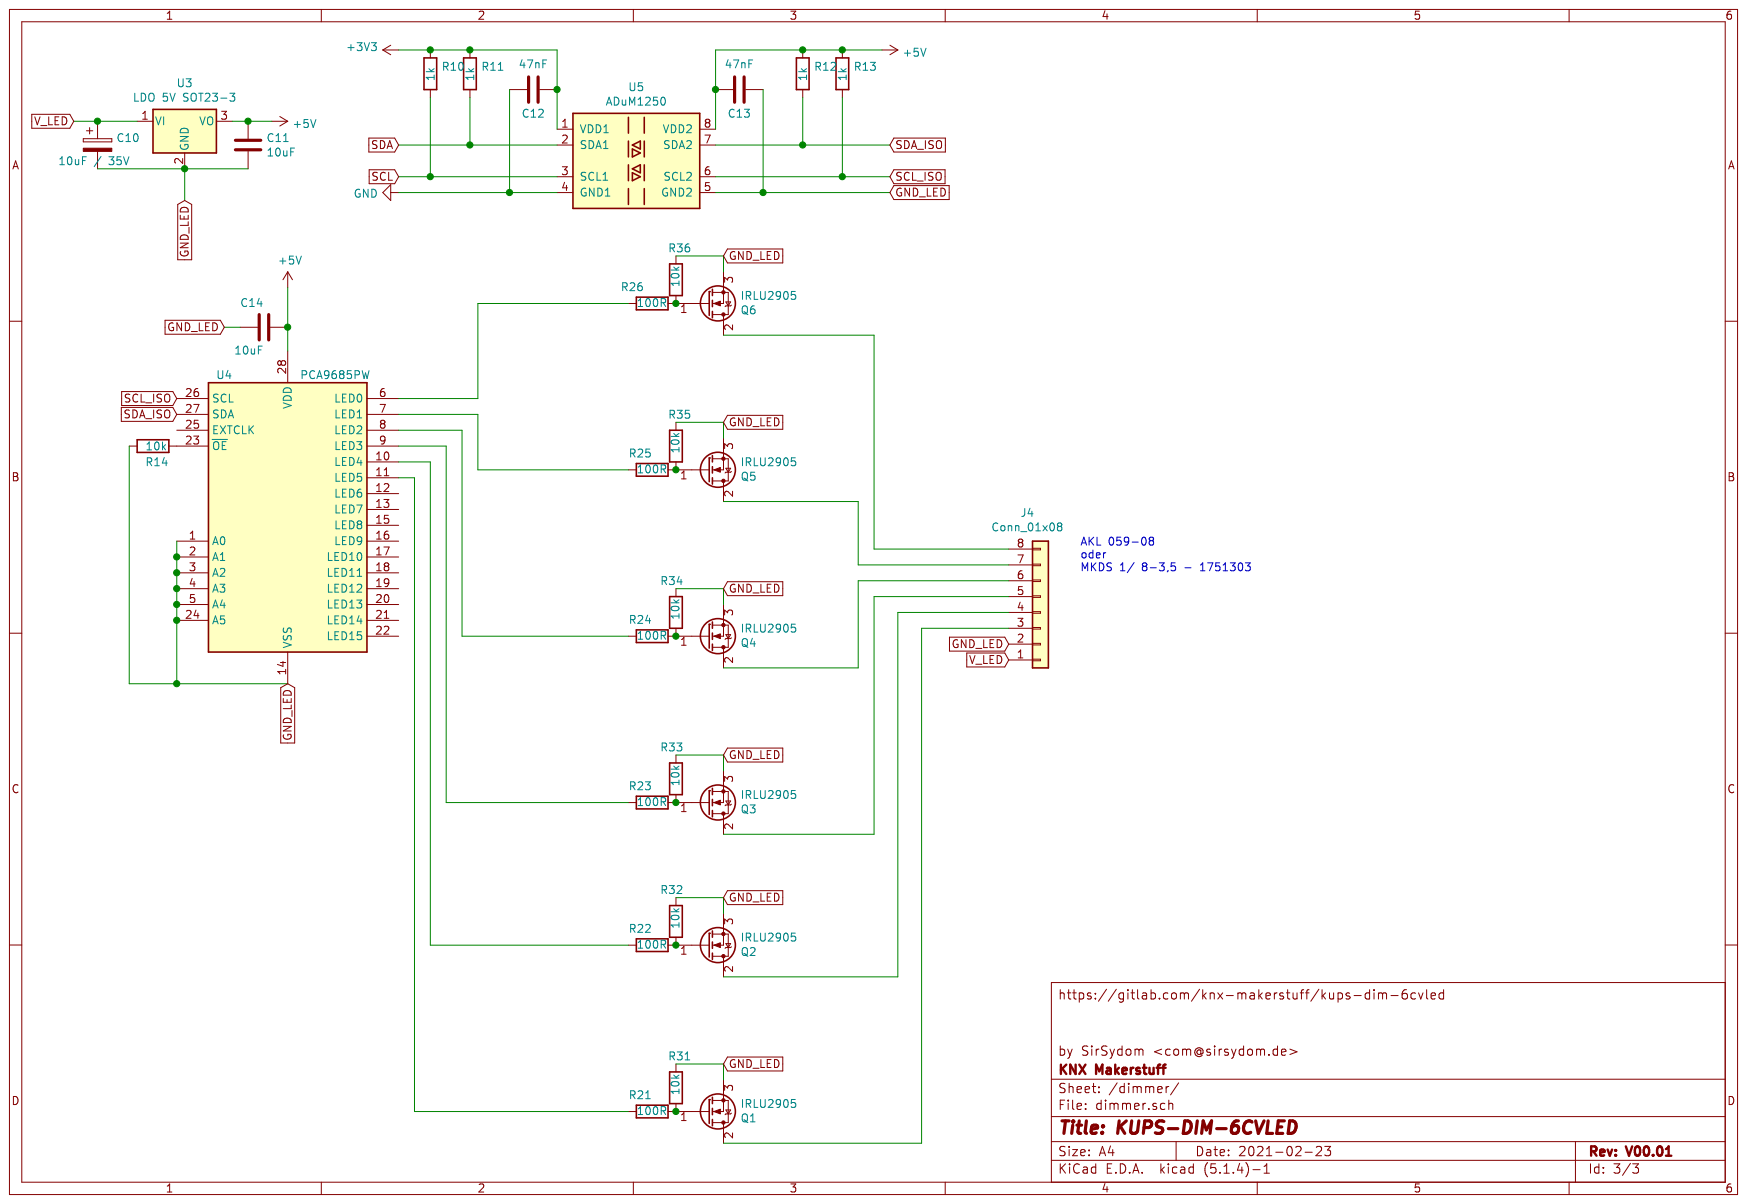
[picture p42: page 3]
