OpenKNX/LED-UP1-6x24V/hardware/EDA-Files/KUPS-DIM-6CVLED - SAMD21/KUPS-DIM-6CVLED_V00.02_Schematic.pdf

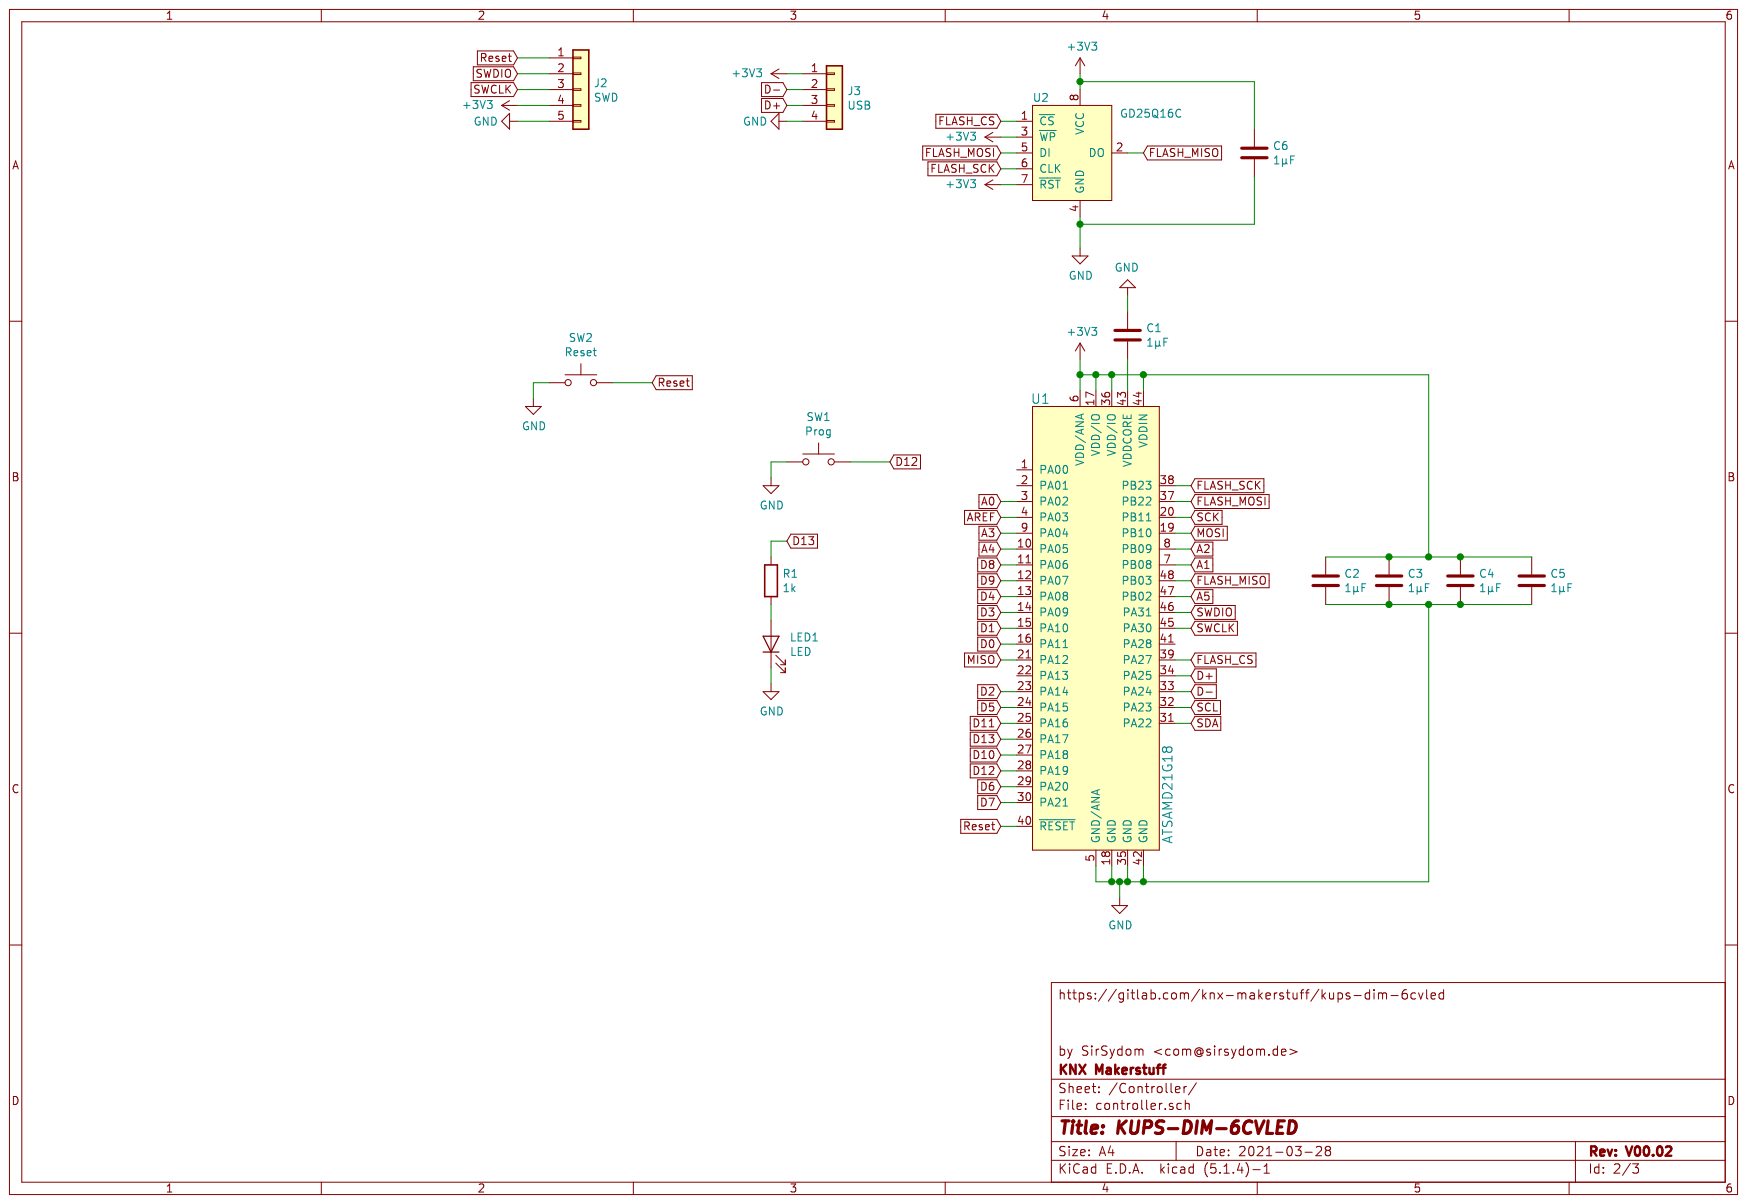
[picture p43: page 2]

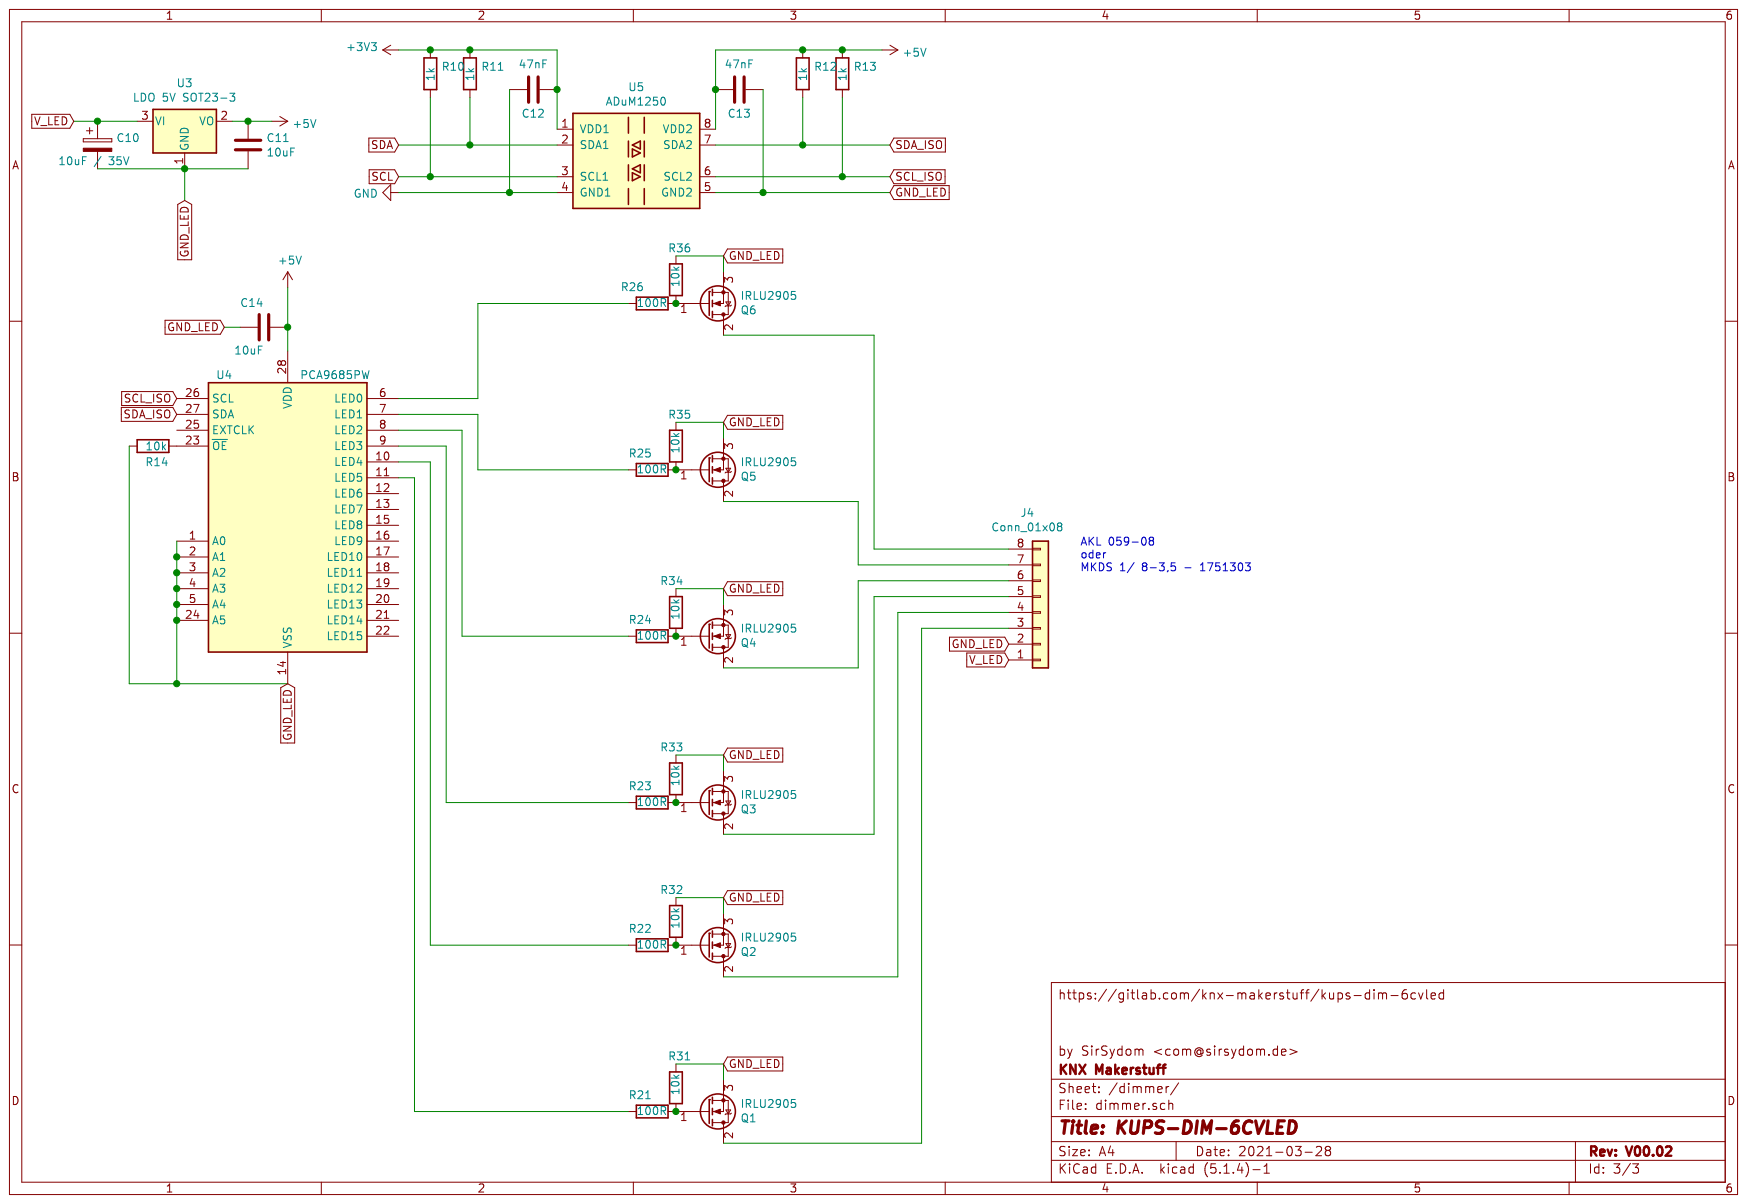
[picture p44: page 3]
