OpenKNX/LED-UP1-6x24V/hardware/EDA-Files/LED-UP1-6x24V/LED-UP1-6x24V.kicad_pcb

## KiCad design hardware/EDA-Files/LED-UP1-6x24V/LED-UP1-6x24V.kicad_pcb (2023-12-05)

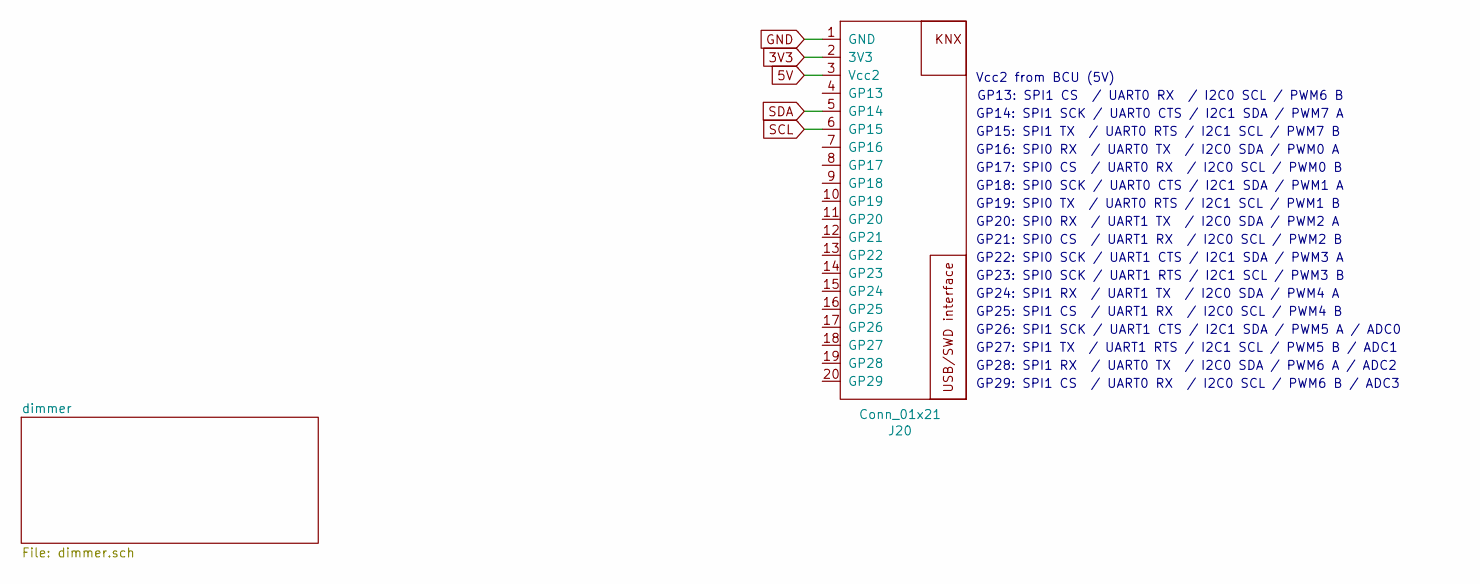
[picture p45: schematic LED-UP1-6x24V.sch, DIM-UP1-6x24V]

Parts:
J20: Conn_01x21; OpenKNX_UP1-PCBConnector_1x20_App_3D

Connections:
3V3: J20.2 (3V3); also elsewhere on the board
5V: J20.3 (Vcc2)
GND: J20.1 (GND); also elsewhere on the board
SCL: J20.6 (GP15); also elsewhere on the board
SDA: J20.5 (GP14); also elsewhere on the board

Notes on the sheet:
GP14: SPI1 SCK / UART0 CTS / I2C1 SDA / PWM7 A
GP15: SPI1 TX / UART0 RTS / I2C1 SCL / PWM7 B
GP18: SPI0 SCK / UART0 CTS / I2C1 SDA / PWM1 A
GP19: SPI0 TX / UART0 RTS / I2C1 SCL / PWM1 B
GP17: SPI0 CS / UART0 RX / I2C0 SCL / PWM0 B
GP16: SPI0 RX / UART0 TX / I2C0 SDA / PWM0 A
GP13: SPI1 CS / UART0 RX / I2C0 SCL / PWM6 B
GP20: SPI0 RX / UART1 TX / I2C0 SDA / PWM2 A
GP21: SPI0 CS / UART1 RX / I2C0 SCL / PWM2 B
GP22: SPI0 SCK / UART1 CTS / I2C1 SDA / PWM3 A
GP23: SPI0 SCK / UART1 RTS / I2C1 SCL / PWM3 B
GP24: SPI1 RX / UART1 TX / I2C0 SDA / PWM4 A
GP25: SPI1 CS / UART1 RX / I2C0 SCL / PWM4 B
GP26: SPI1 SCK / UART1 CTS / I2C1 SDA / PWM5 A / ADC0
GP27: SPI1 TX / UART1 RTS / I2C1 SCL / PWM5 B / ADC1
GP28: SPI1 RX / UART0 TX / I2C0 SDA / PWM6 A / ADC2
GP29: SPI1 CS / UART0 RX / I2C0 SCL / PWM6 B / ADC3
Vcc2 from BCU (5V)

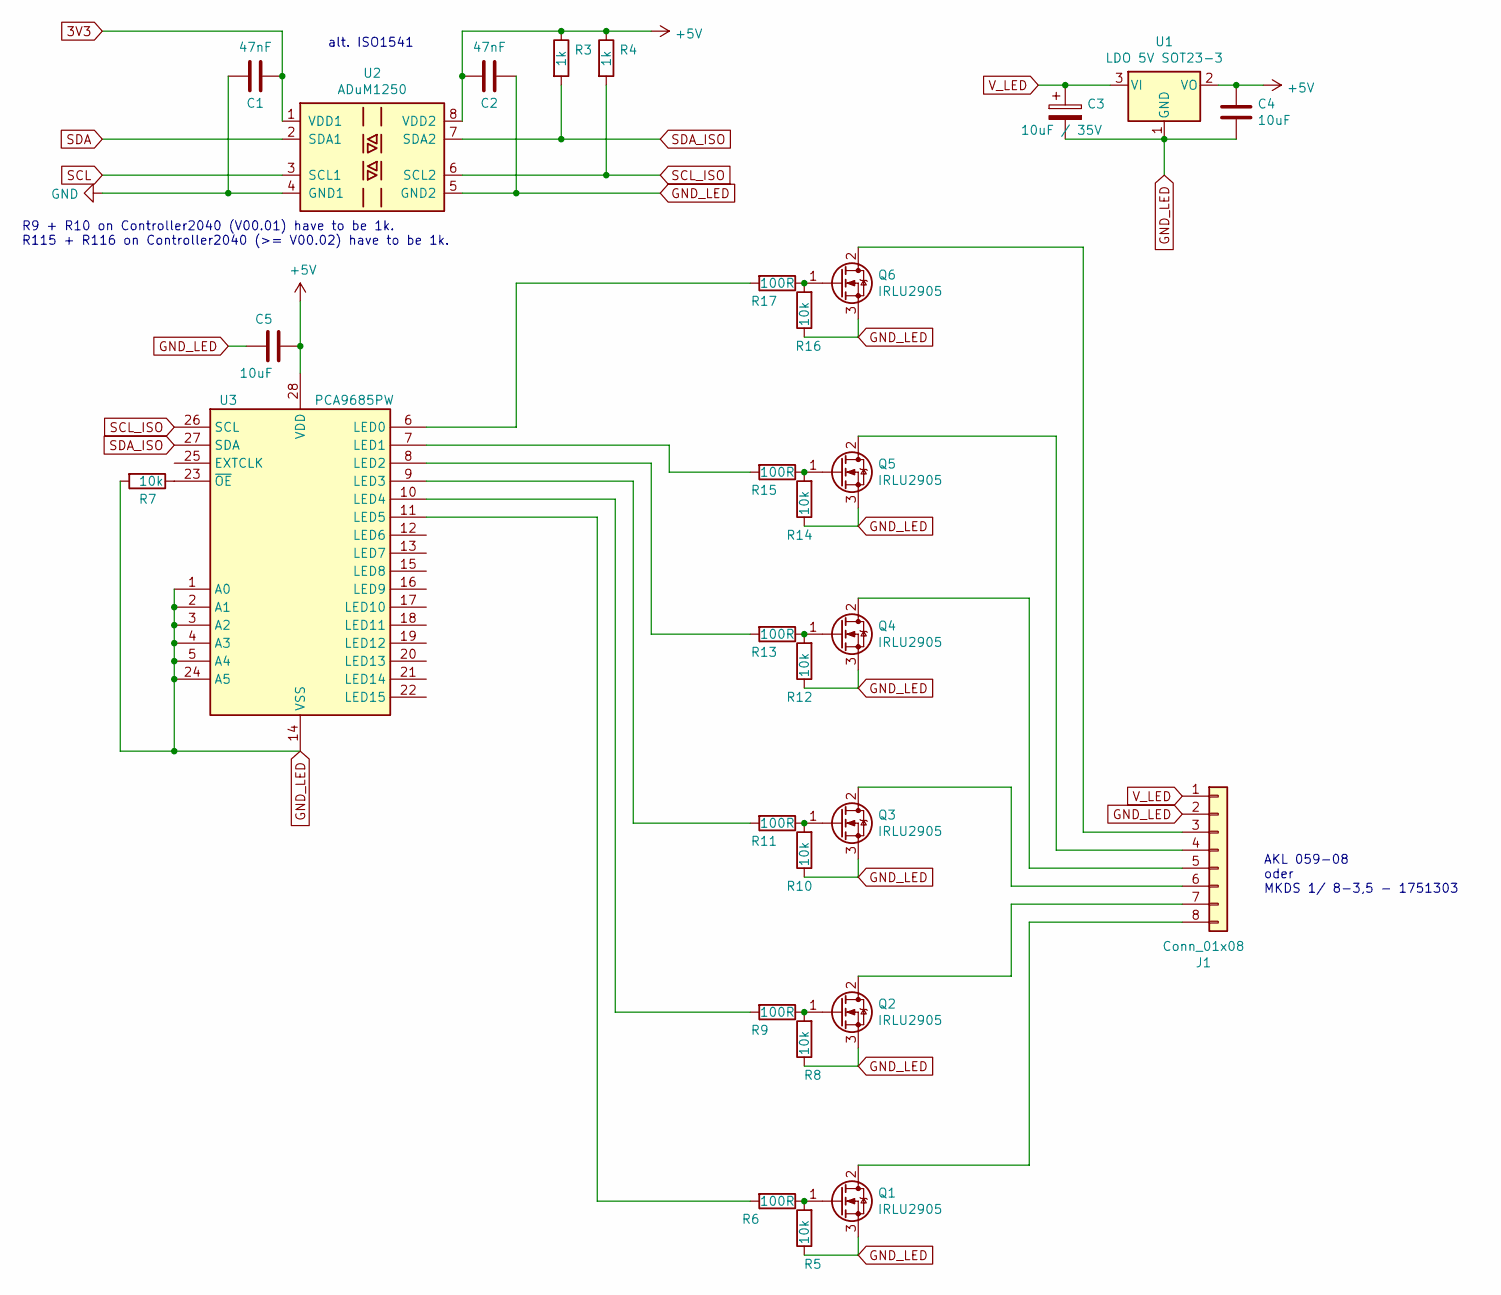
[picture p46: schematic dimmer.sch, DIM-UP1-6x24V]

Parts:
C1, C2: 47nF; C_0805_2012Metric_Pad1.15x1.40mm_HandSolder
C3: 10uF / 35V; CP_Elec_5x5.3
C4: 10uF; C_0603_1608Metric_Pad1.05x0.95mm_HandSolder
C5: 10uF; C_0805_2012Metric
J1: Conn_01x08; PhoenixContact_MKDS_1,5_8-G-3.5_1x08_P3.5mm_Horizontal
Q1, Q2, Q3, Q4, Q5, Q6: IRLU2905; TO-251-3_Vertical_lowprofile
R3, R4: 1k; R_0603_1608Metric_Pad1.05x0.95mm_HandSolder
R5, R7, R8, R10, R12, R14, R16: 10k; R_0603_1608Metric_Pad1.05x0.95mm_HandSolder
R6, R9, R11, R13, R15, R17: 100R; R_0603_1608Metric_Pad1.05x0.95mm_HandSolder
U1: LDO 5V SOT23-3; TSOT-23
U2: ADuM1250; SSOP-8_3.9x5.05mm_P1.27mm
U3: PCA9685PW; TSSOP-28_4.4x9.7mm_P0.65mm_Handsolder

Connections:
3V3: C1.1, U2.1 (VDD1); also elsewhere on the board
+5V: C2.2, C4.1, C5.2, R3.1, R4.1, U1.2 (VO), U2.8 (VDD2), U3.28 (VDD)
GND: C1.2, U2.4 (GND1); also elsewhere on the board
GND_LED: C2.1, C3.2, C4.2, C5.1, J1.2, Q1.3 (S), Q2.3 (S), Q3.3 (S), Q4.3 (S), Q5.3 (S), Q6.3 (S), R5.1, R7.2, R8.1, R10.1, R12.1, R14.1, R16.1, U1.1 (GND), U2.5 (GND2), U3.1 (A0), U3.2 (A1), U3.3 (A2), U3.4 (A3), U3.5 (A4), U3.14 (VSS), U3.24 (A5)
unnamed: J1.3, Q6.2 (D)
unnamed: J1.4, Q5.2 (D)
unnamed: J1.5, Q4.2 (D)
unnamed: J1.6, Q3.2 (D)
unnamed: J1.7, Q2.2 (D)
unnamed: J1.8, Q1.2 (D)
unnamed: Q1.1 (G), R5.2, R6.1
unnamed: Q2.1 (G), R8.2, R9.1
unnamed: Q3.1 (G), R10.2, R11.1
unnamed: Q4.1 (G), R12.2, R13.1
unnamed: Q5.1 (G), R14.2, R15.1
unnamed: Q6.1 (G), R16.2, R17.1
unnamed: R6.2, U3.11 (LED5)
unnamed: R7.1, U3.23 (~OE)
unnamed: R9.2, U3.10 (LED4)
unnamed: R11.2, U3.9 (LED3)
unnamed: R13.2, U3.8 (LED2)
unnamed: R15.2, U3.7 (LED1)
unnamed: R17.2, U3.6 (LED0)
SCL: U2.3 (SCL1); also elsewhere on the board
SCL_ISO: R4.2, U2.6 (SCL2), U3.26 (SCL)
SDA: U2.2 (SDA1); also elsewhere on the board
SDA_ISO: R3.2, U2.7 (SDA2), U3.27 (SDA)
V_LED: C3.1, J1.1, U1.3 (VI)

Notes on the sheet:
AKL 059-08 oder MKDS 1/ 8-3,5 - 1751303
R9 + R10 on Controller2040 (V00.01) have to be 1k. R115 + R116 on Controller2040 (>= V00.02) have to be 1k.
alt. ISO1541

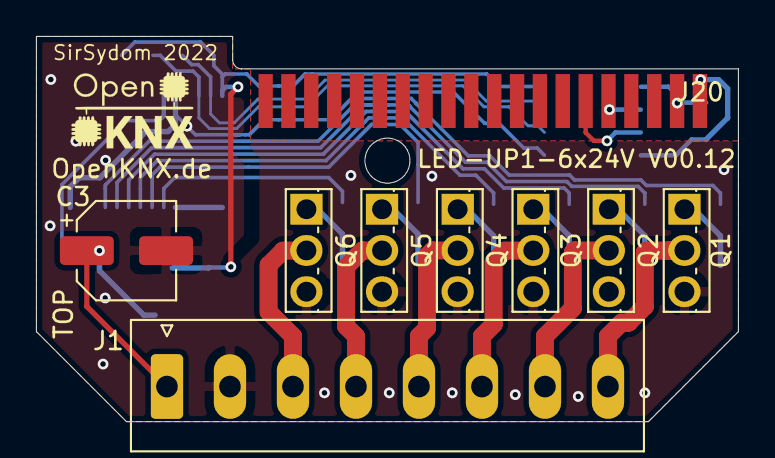
[picture p47: board LED-UP1-6x24V.kicad_pcb from above]

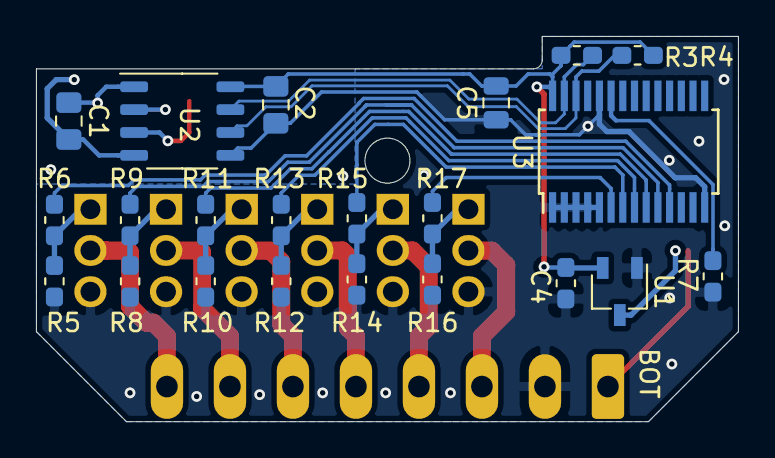
[picture p48: board LED-UP1-6x24V.kicad_pcb from below]

Board: 2 copper layers, 39.0 x 21.4 mm, 31 parts (22 on the bottom side), 28 nets.
