OpenKNX/LED-UP1-6x24V/hardware/EDA-Files/KUPS-DIM-6CVLED - SAMD21/KUPS-DIM-6CVLED.kicad_pcb

## KiCad design hardware/EDA-Files/KUPS-DIM-6CVLED - SAMD21/KUPS-DIM-6CVLED.kicad_pcb (2023-12-05)

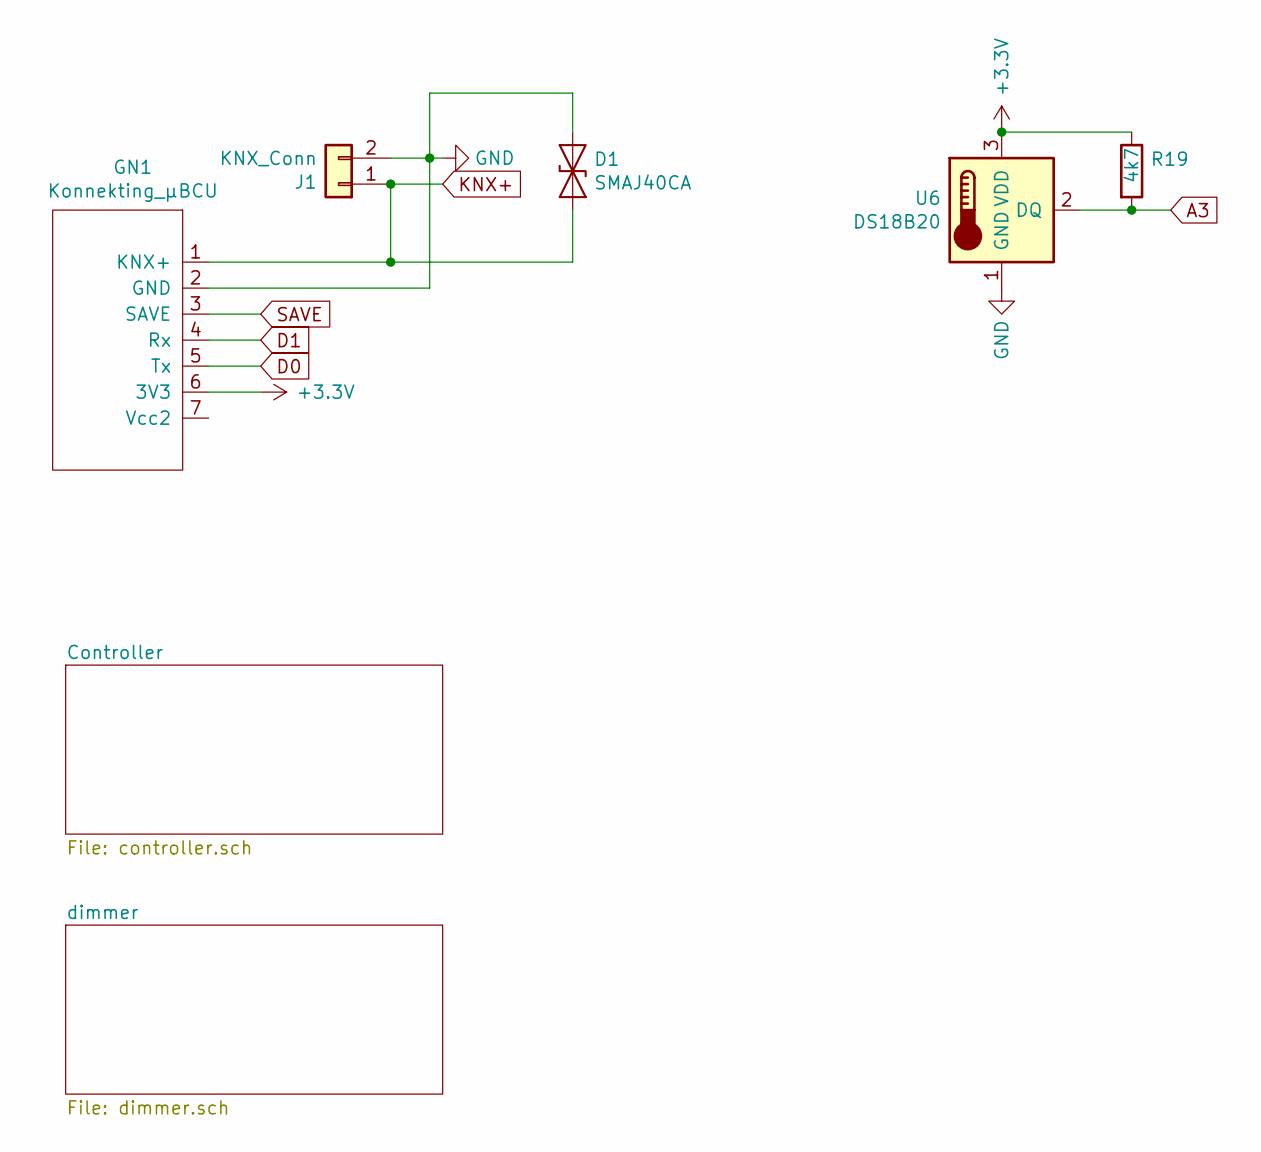
[picture p49: schematic KUPS-DIM-6CVLED.sch]

Parts:
D1: SMAJ40CA; D_SMA
GN1: Konnekting_µBCU; NanoBCU_PinHeader_SMD_low_profile
J1: KNX_Conn; KNX_Connector
R19: 4k7; R_0603_1608Metric_Pad1.05x0.95mm_HandSolder
U6: DS18B20; TO-92_Wide

Connections:
A3: R19.2, U6.2 (DQ); also elsewhere on the board
D0: GN1.5 (Tx); also elsewhere on the board
D1: GN1.4 (Rx); also elsewhere on the board
GND: D1.1 (A1), GN1.2 (GND), J1.2, U6.1 (GND); also elsewhere on the board
KNX+: D1.2 (A2), GN1.1 (KNX+), J1.1
SAVE: GN1.3 (SAVE)

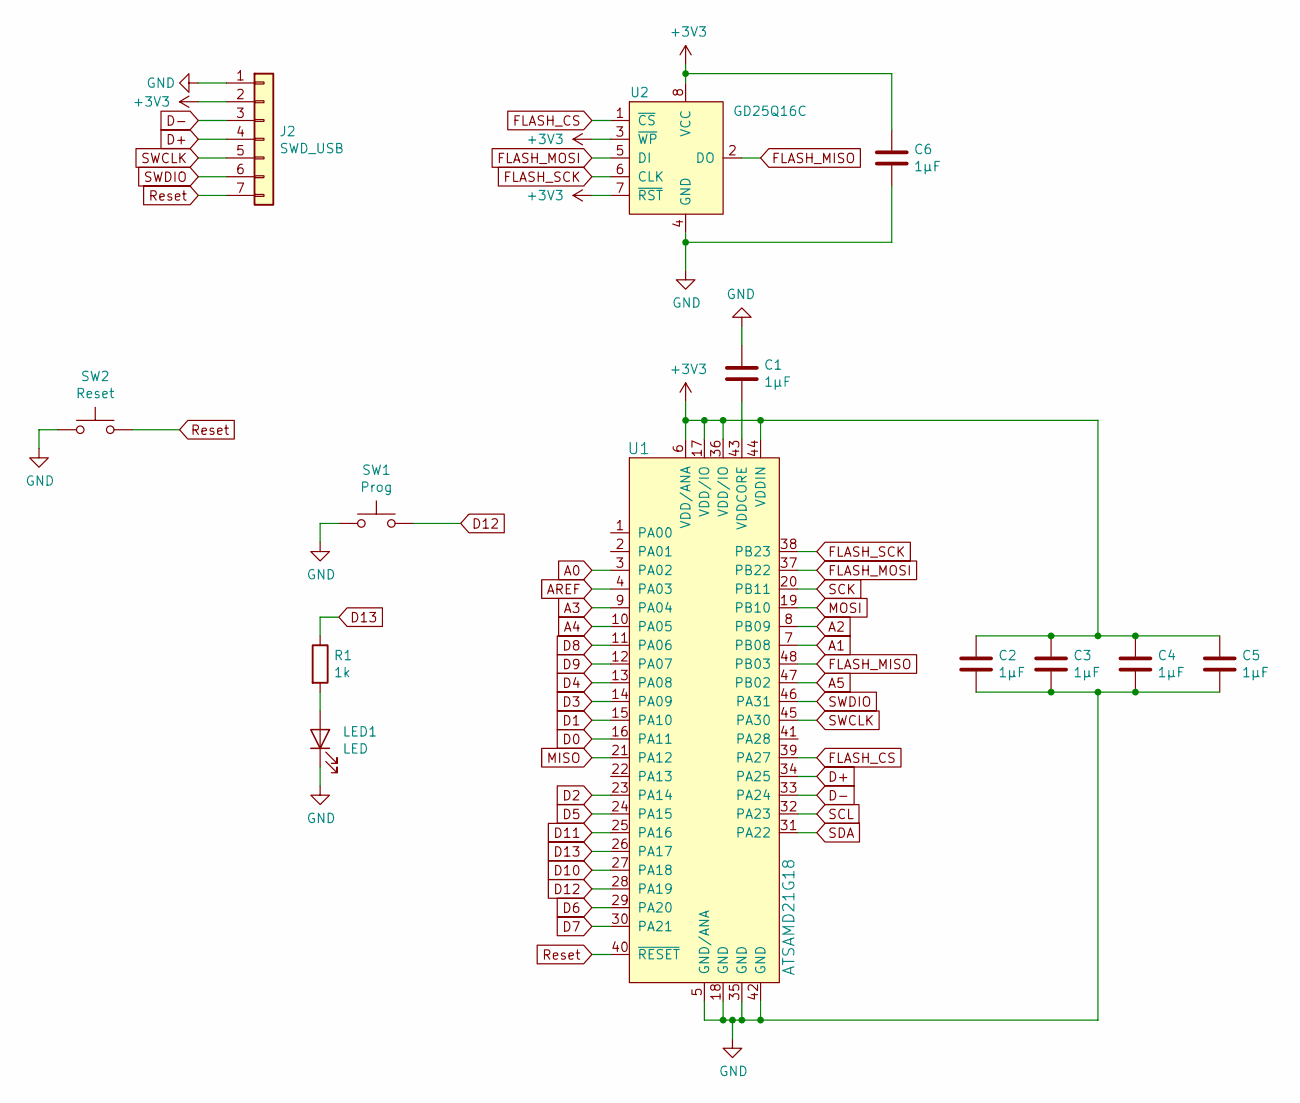
[picture p50: schematic controller.sch, KUPS-DIM-6CVLED]

Parts:
C1, C2, C3, C4, C5, C6: 1µF; C_0603_1608Metric
J2: SWD_USB; PinHeader_1x07_P1.27mm_Vertical
LED1: LED; LED_0603_1608Metric
R1: 1k; R_0603_1608Metric_Pad1.05x0.95mm_HandSolder
SW1: Prog; SW_Push_Xunpu_TS-1089S_Handsolder
SW2: Reset; SW_Push_Xunpu_TS-1089S_Handsolder
U1: ATSAMD21G18; TQFP-48_7x7mm_P0.5mm; MPN ATSAMD21G18A-AUT; Digi-Key_PN ATSAMD21G18A-AUTCT-ND
U2: GD25Q16C; SSOP-8_3.9x5.05mm_P1.27mm; MPN W25Q32JVSSIQ TR; Digi-Key_PN W25Q32JVSSIQCT-ND

Connections:
A0: U1.3 (PA02)
A1: U1.7 (PB08)
A2: U1.8 (PB09)
A3: U1.9 (PA04); also elsewhere on the board
A4: U1.10 (PA05)
A5: U1.47 (PB02)
AREF: U1.4 (PA03)
D0: U1.16 (PA11); also elsewhere on the board
D1: U1.15 (PA10); also elsewhere on the board
D2: U1.23 (PA14)
D3: U1.14 (PA09)
D4: U1.13 (PA08)
D5: U1.24 (PA15)
D6: U1.29 (PA20)
D7: U1.30 (PA21)
D8: U1.11 (PA06)
D9: U1.12 (PA07)
D10: U1.27 (PA18)
D11: U1.25 (PA16)
D12: SW1.2, U1.28 (PA19)
D13: R1.1, U1.26 (PA17)
D+: J2.4, U1.34 (PA25)
D-: J2.3, U1.33 (PA24)
FLASH_CS: U1.39 (PA27), U2.1 (~CS)
FLASH_MISO: U1.48 (PB03), U2.2 (DO)
FLASH_MOSI: U1.37 (PB22), U2.5 (DI)
FLASH_SCK: U1.38 (PB23), U2.6 (CLK)
GND: C1.1, C2.2, C3.2, C4.2, C5.2, C6.2, J2.1, LED1.1 (K), SW1.1, SW2.1, U1.5 (GND/ANA), U1.18 (GND), U1.35 (GND), U1.42 (GND), U2.4 (GND); also elsewhere on the board
MISO: U1.21 (PA12)
MOSI: U1.19 (PB10)
unnamed: C1.2, U1.43 (VDDCORE)
unnamed: LED1.2 (A), R1.2
Reset: J2.7, SW2.2, U1.40 (~RESET)
SCK: U1.20 (PB11)
SCL: U1.32 (PA23); also elsewhere on the board
SDA: U1.31 (PA22); also elsewhere on the board
SWCLK: J2.5, U1.45 (PA30)
SWDIO: J2.6, U1.46 (PA31)

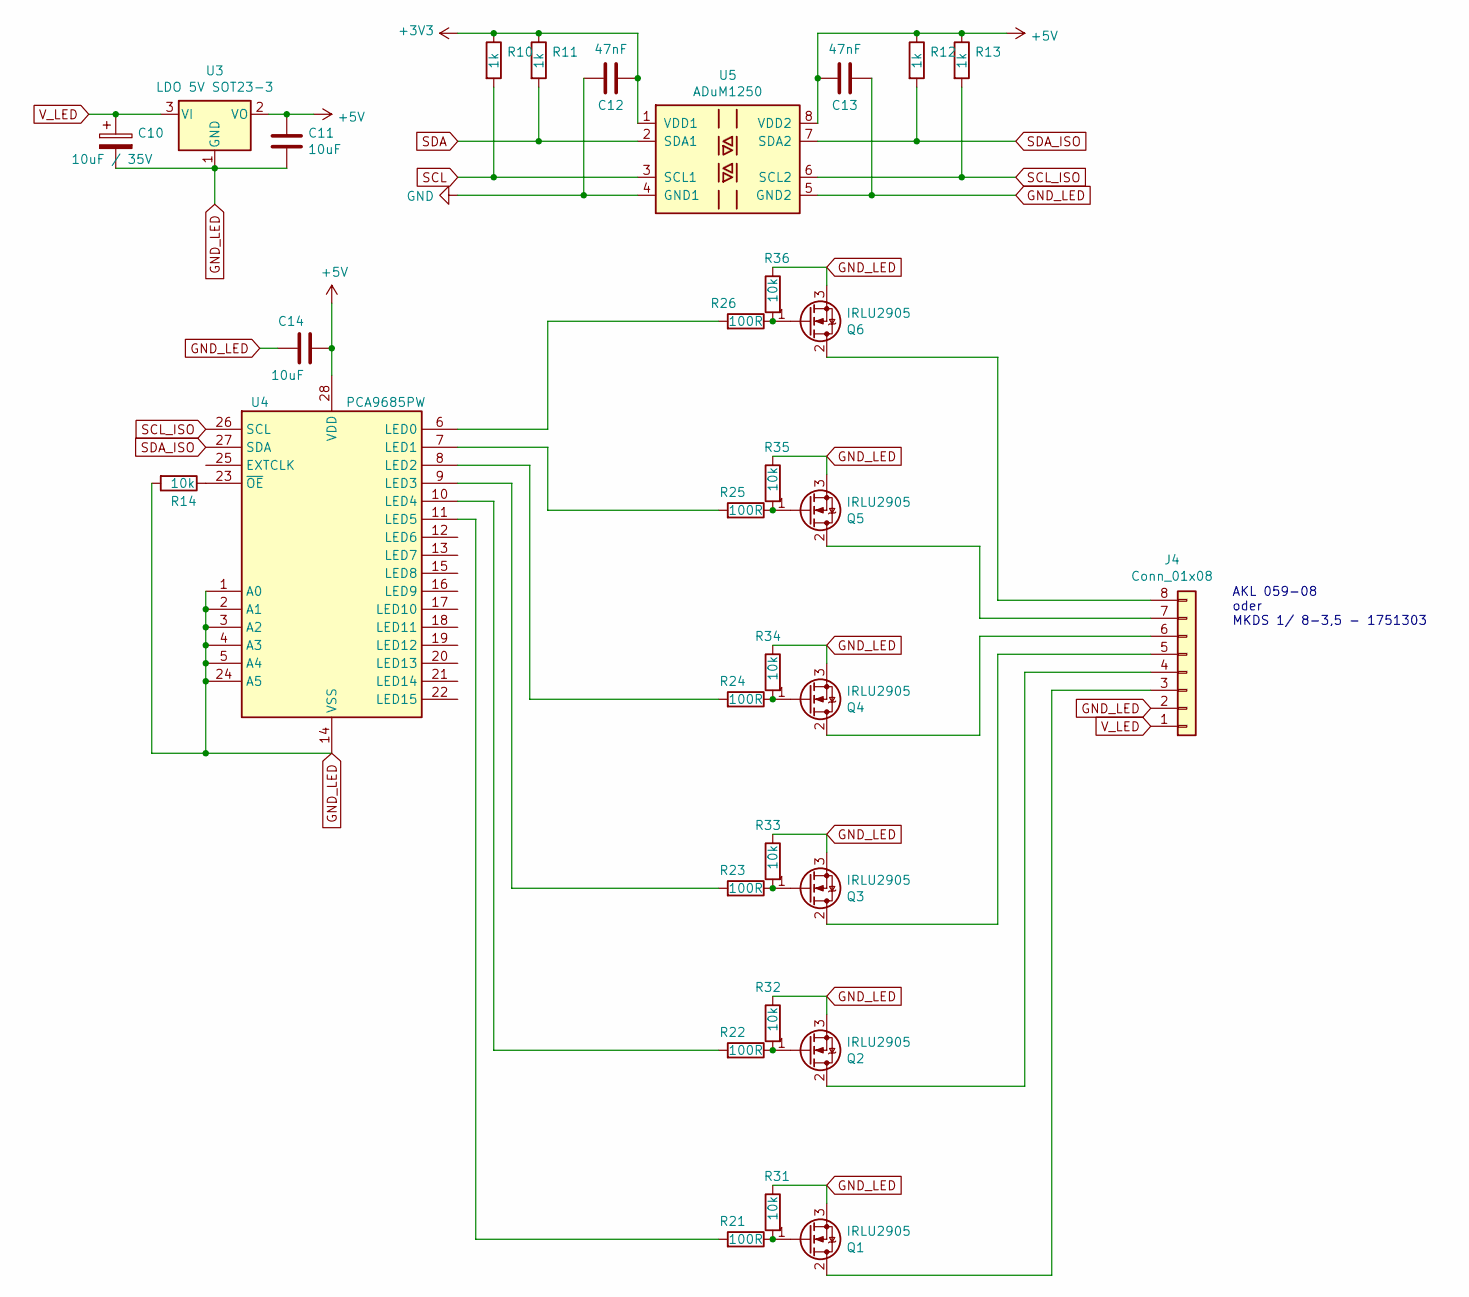
[picture p51: schematic dimmer.sch, KUPS-DIM-6CVLED]

Parts:
C10: 10uF / 35V; CP_Elec_5x5.3
C11, C14: 10uF; C_0603_1608Metric_Pad1.05x0.95mm_HandSolder
C12, C13: 47nF; C_0805_2012Metric_Pad1.15x1.40mm_HandSolder
J4: Conn_01x08; PhoenixContact_MKDS_1,5_8-G-3.5_1x08_P3.5mm_Horizontal
Q1, Q2, Q3, Q4, Q5, Q6: IRLU2905; TO-251-3_Vertical_lowprofile
R10, R11, R12, R13: 1k; R_0603_1608Metric_Pad1.05x0.95mm_HandSolder
R14, R31, R32, R33, R34, R35, R36: 10k; R_0603_1608Metric_Pad1.05x0.95mm_HandSolder
R21, R22, R23, R24, R25, R26: 100R; R_0603_1608Metric_Pad1.05x0.95mm_HandSolder
U3: LDO 5V SOT23-3; TSOT-23
U4: PCA9685PW; TSSOP-28_4.4x9.7mm_P0.65mm_Handsolder
U5: ADuM1250; SSOP-8_3.9x5.05mm_P1.27mm

Connections:
+5V: C11.1, C13.2, C14.2, R12.1, R13.1, U3.2 (VO), U4.28 (VDD), U5.8 (VDD2)
GND: C12.2, U5.4 (GND1); also elsewhere on the board
GND_LED: C10.2, C11.2, C13.1, C14.1, J4.2, Q1.3 (S), Q2.3 (S), Q3.3 (S), Q4.3 (S), Q5.3 (S), Q6.3 (S), R14.2, R31.1, R32.1, R33.1, R34.1, R35.1, R36.1, U3.1 (GND), U4.1 (A0), U4.2 (A1), U4.3 (A2), U4.4 (A3), U4.5 (A4), U4.14 (VSS), U4.24 (A5), U5.5 (GND2)
unnamed: J4.3, Q1.2 (D)
unnamed: J4.4, Q2.2 (D)
unnamed: J4.5, Q3.2 (D)
unnamed: J4.6, Q4.2 (D)
unnamed: J4.7, Q5.2 (D)
unnamed: J4.8, Q6.2 (D)
unnamed: Q1.1 (G), R21.1, R31.2
unnamed: Q2.1 (G), R22.1, R32.2
unnamed: Q3.1 (G), R23.1, R33.2
unnamed: Q4.1 (G), R24.1, R34.2
unnamed: Q5.1 (G), R25.1, R35.2
unnamed: Q6.1 (G), R26.1, R36.2
unnamed: R14.1, U4.23 (~OE)
unnamed: R21.2, U4.11 (LED5)
unnamed: R22.2, U4.10 (LED4)
unnamed: R23.2, U4.9 (LED3)
unnamed: R24.2, U4.8 (LED2)
unnamed: R25.2, U4.7 (LED1)
unnamed: R26.2, U4.6 (LED0)
SCL: R10.2, U5.3 (SCL1); also elsewhere on the board
SCL_ISO: R13.2, U4.26 (SCL), U5.6 (SCL2)
SDA: R11.2, U5.2 (SDA1); also elsewhere on the board
SDA_ISO: R12.2, U4.27 (SDA), U5.7 (SDA2)
V_LED: C10.1, J4.1, U3.3 (VI)

Notes on the sheet:
AKL 059-08 oder MKDS 1/ 8-3,5 - 1751303

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
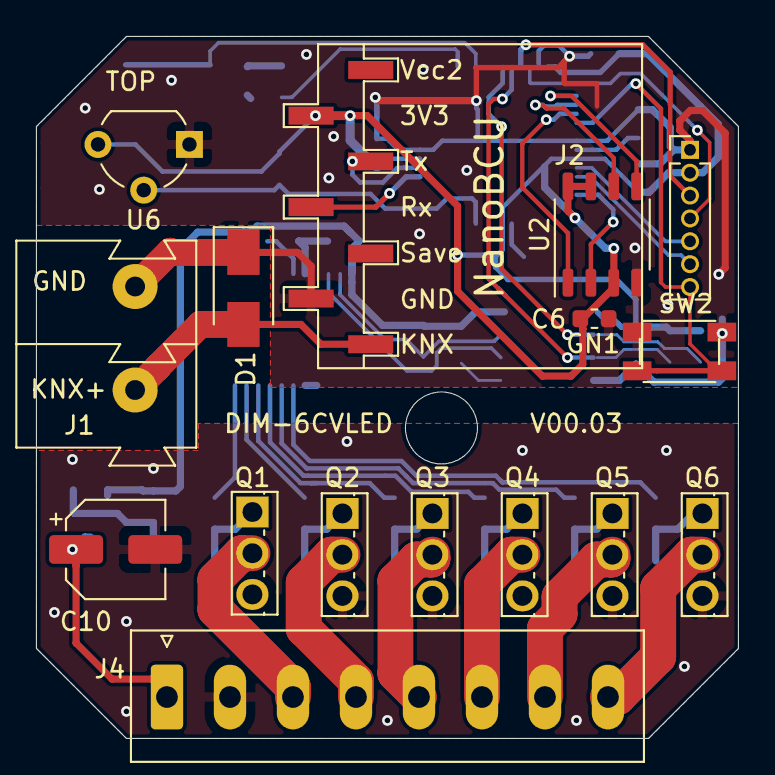
[picture p52: board KUPS-DIM-6CVLED.kicad_pcb from above]

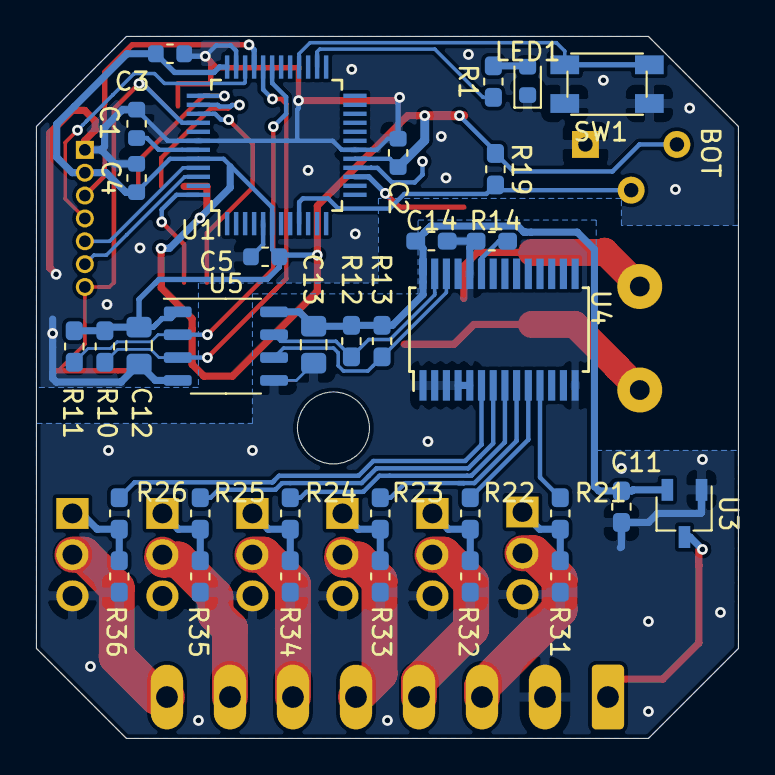
[picture p53: board KUPS-DIM-6CVLED.kicad_pcb from below]

Board: 2 copper layers, 39.0 x 39.0 mm, 50 parts (34 on the bottom side), 45 nets.
