OpenKNX/LED-UP1-6x24V/konnekting_software/DIM-6CVLED.01/kdevice.h

      
KnxComObject KnxDevice::_comObjectsList[] = {
    /* Index 0 - ch_A_sw */ KnxComObject(KNX_DPT_1_001, 0x28),
    /* Index 1 - ch_A_dim */ KnxComObject(KNX_DPT_5_001, 0x28),
    /* Index 2 - ch_A_dimrel */ KnxComObject(KNX_DPT_3_007, 0x28),
    /* Index 3 - ch_A_lock */ KnxComObject(KNX_DPT_1_003, 0x38),
    /* Index 4 - ch_A_scene */ KnxComObject(KNX_DPT_17_001, 0x38),
    /* Index 5 - ch_A_stat_sw */ KnxComObject(KNX_DPT_1_001, 0x34),
    /* Index 6 - ch_A_stat_dim */ KnxComObject(KNX_DPT_5_001, 0x34),
    /* Index 7 - ch_B_sw */ KnxComObject(KNX_DPT_1_001, 0x28),
    /* Index 8 - ch_B_dim */ KnxComObject(KNX_DPT_5_001, 0x28),
    /* Index 9 - ch_B_dimrel */ KnxComObject(KNX_DPT_3_007, 0x28),
    /* Index 10 - ch_B_lock */ KnxComObject(KNX_DPT_1_003, 0x38),
    /* Index 11 - ch_B_scene */ KnxComObject(KNX_DPT_17_001, 0x38),
    /* Index 12 - ch_B_stat_sw */ KnxComObject(KNX_DPT_1_001, 0x34),
    /* Index 13 - ch_B_stat_dim */ KnxComObject(KNX_DPT_5_001, 0x34),
    /* Index 14 - ch_C_sw */ KnxComObject(KNX_DPT_1_001, 0x28),
    /* Index 15 - ch_C_dim */ KnxComObject(KNX_DPT_5_001, 0x28),
    /* Index 16 - ch_C_dimrel */ KnxComObject(KNX_DPT_3_007, 0x28),
    /* Index 17 - ch_C_lock */ KnxComObject(KNX_DPT_1_003, 0x38),
    /* Index 18 - ch_C_scene */ KnxComObject(KNX_DPT_17_001, 0x38),
    /* Index 19 - ch_C_stat_sw */ KnxComObject(KNX_DPT_1_001, 0x34),
    /* Index 20 - ch_C_stat_dim */ KnxComObject(KNX_DPT_5_001, 0x34),
    /* Index 21 - ch_D_sw */ KnxComObject(KNX_DPT_1_001, 0x28),
    /* Index 22 - ch_D_dim */ KnxComObject(KNX_DPT_5_001, 0x28),
    /* Index 23 - ch_D_dimrel */ KnxComObject(KNX_DPT_3_007, 0x28),
    /* Index 24 - ch_D_lock */ KnxComObject(KNX_DPT_1_003, 0x38),
    /* Index 25 - ch_D_scene */ KnxComObject(KNX_DPT_17_001, 0x38),
    /* Index 26 - ch_D_stat_sw */ KnxComObject(KNX_DPT_1_001, 0x34),
    /* Index 27 - ch_D_stat_dim */ KnxComObject(KNX_DPT_5_001, 0x34),
    /* Index 28 - ch_E_sw */ KnxComObject(KNX_DPT_1_001, 0x28),
    /* Index 29 - ch_E_dim */ KnxComObject(KNX_DPT_5_001, 0x28),
    /* Index 30 - ch_E_dimrel */ KnxComObject(KNX_DPT_3_007, 0x28),
    /* Index 31 - ch_E_lock */ KnxComObject(KNX_DPT_1_003, 0x38),
    /* Index 32 - ch_E_scene */ KnxComObject(KNX_DPT_17_001, 0x38),
    /* Index 33 - ch_E_stat_sw */ KnxComObject(KNX_DPT_1_001, 0x34),
    /* Index 34 - ch_E_stat_dim */ KnxComObject(KNX_DPT_5_001, 0x34),
    /* Index 35 - ch_F_sw */ KnxComObject(KNX_DPT_1_001, 0x28),
    /* Index 36 - ch_F_dim */ KnxComObject(KNX_DPT_5_001, 0x28),
    /* Index 37 - ch_F_dimrel */ KnxComObject(KNX_DPT_3_007, 0x28),
    /* Index 38 - ch_F_lock */ KnxComObject(KNX_DPT_1_003, 0x38),
    /* Index 39 - ch_F_scene */ KnxComObject(KNX_DPT_17_001, 0x38),
    /* Index 40 - ch_F_stat_sw */ KnxComObject(KNX_DPT_1_001, 0x34),
    /* Index 41 - ch_F_stat_dim */ KnxComObject(KNX_DPT_5_001, 0x34),
    /* Index 42 - ch_ABC_sw */ KnxComObject(KNX_DPT_1_001, 0x28),
    /* Index 43 - ch_ABC_dim */ KnxComObject(KNX_DPT_232_600, 0x28),
    /* Index 44 - ch_ABC_animation */ KnxComObject(KNX_DPT_5_010, 0x38),
    /* Index 45 - ch_ABC_lock */ KnxComObject(KNX_DPT_1_003, 0x38),
    /* Index 46 - ch_ABC_scene */ KnxComObject(KNX_DPT_17_001, 0x38),
    /* Index 47 - ch_ABC_stat_sw */ KnxComObject(KNX_DPT_1_001, 0x34),
    /* Index 48 - ch_ABC_stat_dim */ KnxComObject(KNX_DPT_232_600, 0x34),
    /* Index 49 - ch_DEF_sw */ KnxComObject(KNX_DPT_1_001, 0x28),
    /* Index 50 - ch_DEF_dim */ KnxComObject(KNX_DPT_232_600, 0x28),
    /* Index 51 - ch_DEF_animation */ KnxComObject(KNX_DPT_5_010, 0x38),
    /* Index 52 - ch_DEF_lock */ KnxComObject(KNX_DPT_1_003, 0x38),
    /* Index 53 - ch_DEF_scene */ KnxComObject(KNX_DPT_17_001, 0x38),
    /* Index 54 - ch_DEF_stat_sw */ KnxComObject(KNX_DPT_1_001, 0x34),
    /* Index 55 - ch_DEF_stat_dim */ KnxComObject(KNX_DPT_232_600, 0x34),
    /* Index 56 - gen_casetemp */ KnxComObject(KNX_DPT_9_001, 0x30),
    /* Index 57 - gen_temp_alarm */ KnxComObject(KNX_DPT_1_005, 0x34),
    /* Index 58 - gen_daynight */ KnxComObject(KNX_DPT_1_001, 0x2a),
    /* Index 59 - gen_datetime */ KnxComObject(KNX_DPT_19_001, 0x2a),
    /* Index 60 - error_code */ KnxComObject(KNX_DPT_12_001, 0x34)
};
const byte KnxDevice::_numberOfComObjects = sizeof (_comObjectsList) / sizeof (KnxComObject); // do not change this code
       
byte KonnektingDevice::_paramSizeList[] = {
    /* Index 0 - ch_ABC_mode */ PARAM_UINT8,
    /* Index 1 - ch_DEF_mode */ PARAM_UINT8,
    /* Index 2 - ch_A_sw_on_dim */ PARAM_UINT8,
    /* Index 3 - ch_A_fade_time */ PARAM_UINT8,
    /* Index 4 - ch_A_lock_mode */ PARAM_UINT8,
    /* Index 5 - ch_A_lock_time */ PARAM_UINT16,
    /* Index 6 - ch_A_autooff_time */ PARAM_UINT16,
    /* Index 7 - ch_A_switchvalues */ PARAM_RAW2,
    /* Index 8 - ch_B_sw_on_dim */ PARAM_UINT8,
    /* Index 9 - ch_B_fade_time */ PARAM_UINT8,
    /* Index 10 - ch_B_lock_mode */ PARAM_UINT8,
    /* Index 11 - ch_B_lock_time */ PARAM_UINT16,
    /* Index 12 - ch_B_autooff_time */ PARAM_UINT16,
    /* Index 13 - ch_B_switchvalues */ PARAM_RAW2,
    /* Index 14 - ch_C_sw_on_dim */ PARAM_UINT8,
    /* Index 15 - ch_C_fade_time */ PARAM_UINT8,
    /* Index 16 - ch_C_lock_mode */ PARAM_UINT8,
    /* Index 17 - ch_C_lock_time */ PARAM_UINT16,
    /* Index 18 - ch_C_autooff_time */ PARAM_UINT16,
    /* Index 19 - ch_C_switchvalues */ PARAM_RAW2,
    /* Index 20 - ch_D_sw_on_dim */ PARAM_UINT8,
    /* Index 21 - ch_D_fade_time */ PARAM_UINT8,
    /* Index 22 - ch_D_lock_mode */ PARAM_UINT8,
    /* Index 23 - ch_D_lock_time */ PARAM_UINT16,
    /* Index 24 - ch_D_autooff_time */ PARAM_UINT16,
    /* Index 25 - ch_D_switchvalues */ PARAM_RAW2,
    /* Index 26 - ch_E_sw_on_dim */ PARAM_UINT8,
    /* Index 27 - ch_E_fade_time */ PARAM_UINT8,
    /* Index 28 - ch_E_lock_mode */ PARAM_UINT8,
    /* Index 29 - ch_E_lock_time */ PARAM_UINT16,
    /* Index 30 - ch_E_autooff_time */ PARAM_UINT16,
    /* Index 31 - ch_E_switchvalues */ PARAM_RAW2,
    /* Index 32 - ch_F_sw_on_dim */ PARAM_UINT8,
    /* Index 33 - ch_F_fade_time */ PARAM_UINT8,
    /* Index 34 - ch_F_lock_mode */ PARAM_UINT8,
    /* Index 35 - ch_F_lock_time */ PARAM_UINT16,
    /* Index 36 - ch_F_autooff_time */ PARAM_UINT16,
    /* Index 37 - ch_F_switchvalues */ PARAM_RAW2,
    /* Index 38 - ch_ABC_sw_on_dim */ PARAM_UINT8,
    /* Index 39 - ch_ABC_fade_time */ PARAM_UINT8,
    /* Index 40 - ch_ABC_lock_mode */ PARAM_UINT8,
    /* Index 41 - ch_ABC_lock_time */ PARAM_UINT16,
    /* Index 42 - ch_ABC_autooff_time */ PARAM_UINT16,
    /* Index 43 - ch_ABC_switchvalues */ PARAM_RAW6,
    /* Index 44 - ch_DEF_sw_on_dim */ PARAM_UINT8,
    /* Index 45 - ch_DEF_fade_time */ PARAM_UINT8,
    /* Index 46 - ch_DEF_lock_mode */ PARAM_UINT8,
    /* Index 47 - ch_DEF_lock_time */ PARAM_UINT16,
    /* Index 48 - ch_DEF_autooff_time */ PARAM_UINT16,
    /* Index 49 - ch_DEF_switchvalues */ PARAM_RAW6
};
const int KonnektingDevice::_numberOfParams = sizeof (_paramSizeList); // do not change this code
