OpenKNX/LED-UP1-6x24V/konnekting_software/DIM-6CVLED.01/Dimmer.h

#pragma once

#include <KonnektingDevice.h>
#include "config.h"
#include "DimmChannel_1ch.h"
#include "DimmChannel_RGB.h"


class Dimmer
{
    //members
    uint8_t m_NoOfDimmChannels;
    uint8_t m_currentDimmChannel = 0;
    DimmChannel *m_DimmChannels[NO_OF_CHANNELS];
    HardwareChannel *m_HardwareChannels[NO_OF_CHANNELS];
    bool m_FlashAllChannels = false;
    uint8_t m_FlashAllChannels_cnt = 0;

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

    public: void KnxEvent(byte index);
	
	public: void Cyclic();

    public: void CyclicMax();

    public: void Refresh();

    public: void Shutdown();

    public: void FlashAllChannels(bool state);

    private: void FlashAllChannelsCyclic();
};
