OpenKNX/LED-UP1-6x24V/konnekting_software/build_DIM-6CVLED01/sketch/DimmChannel_RGB.h

#line 1 "d:\\Data\\Eigene Dokumente\\Projekte\\EIB\\OpenKNX\\SirSydom-Repos\\LED-UP1-6x24V\\software\\DIM-6CVLED.01\\DimmChannel_RGB.h"
#pragma once

#include <KonnektingDevice.h>
#include "HardwareChannel.h"
#include "HardwareChannel_mega8.h"
#include "HardwareChannel_pca9685.h"
#include "config.h"
#include "DimmChannel.h"


class DimmChannel_RGB : public DimmChannel
{
  private: HardwareChannel* m_hardwareChannel_R;
  private: HardwareChannel* m_hardwareChannel_G;
  private: HardwareChannel* m_hardwareChannel_B;
  private: HardwareChannel *m_hardwareChannels[3];

  //params
  private: uint8_t m_fading_time;
  private: bool m_sw_on_dim;
  private: bool m_sw_off_dim;
  private: uint8_t m_switchonvalue_day[3] = {0, 0, 0};
  private: uint8_t m_switchonvalue_night[3] = {0, 0, 0};
  private: uint16_t m_lock_time = 0;   // fallback time after lock [min]
  private: uint8_t m_lock_mode = 0;   // lock m_lock_mode
  private: uint16_t m_autooff_time = 0;   // automatic off switch time [min]
  
  private: byte m_comobj_sw;
  private: byte m_comobj_sw_stat;
  private: byte m_comobj_dim;
  private: byte m_comobj_dim_stat;
  private: byte m_comobj_lock;
  private: byte m_comobj_scene;
  private: byte m_comobj_animation;
  
  private: uint8_t m_currentSwValue = 0;
  private: uint8_t m_currentDimValue[3] = {255, 255, 255};

  private: uint32_t m_current_animation = 0;
  private: uint32_t m_current_animationstep = 0;
  
  private: uint8_t m_fade_base[3] = {0,0,0};
  private: uint8_t m_fade_goal[3] = {0,0,0};
  private: uint8_t m_fade_steps[3] = {0,0,0};
  private: uint8_t m_fade_step[3] = {0,0,0};
  private: uint8_t m_fade_dir[3] = {0,0,0};

  private: bool m_daynight = false;    // 0 = Day, 1 = Night
  private: uint32_t m_autooff_counter = 0;
  private: uint32_t m_lock_counter = 0;
  private: uint8_t m_lock_state = 0;    // 0 = no lock, != 0 lock
  private: uint8_t m_lock_values[3] = {0,0,0};     // current dimm value due to lock
  private: uint32_t m_lock_animation = 0;

  //constructors
  public: DimmChannel_RGB(HardwareChannel* hardwareChannel_R, HardwareChannel* hardwareChannel_G, HardwareChannel* hardwareChannel_B, uint8_t fading_time, uint8_t sw_on_dim, uint8_t switchonvalue[], uint8_t lock_mode, uint16_t lock_time, uint16_t autooff_time, byte first_comobj);
  
  public: void KnxEvent(byte index);
  
  public: void Cyclic();

  public: void Shutdown();
  
  private: void Switch(bool value);

  private: void Switch(bool value, bool ignore_sw_on_values);
  
  private: void Dimm(byte value[]);
  
  private: void Fade(byte value[]);

  private: void ExecFadeStep();

  private: void ExecAnimation();

  private: void Lock(uint8_t value);

  private: void Scene(uint8_t value);

  private: void Animation(uint16_t value);

  public: void Refresh();

  private: void RefreshAutoOffTimer();

  private: void EvaluateAutoOffTimer();

  private: void SetValues(uint8_t values[]);

  private: void RainbowColorFromStep(uint16_t step, uint8_t rgb[]);

  private: void SetLockTimer();

  private: void EvaluateLockTimer();

  private: void Unlock();

  private: void Lock_ON();

  private: void Lock_OFF();

  private: void Lock_FREEZE();
};
