OpenKNX/LED-UP1-6x24V/(commit log)

2022-02-16 added docu
    [LED-UP1-6x24V_V00.11.stl]
2022-02-24 first draft of case
    [C1_C_0805_2012Metric_61F44309.CATPart, C2_C_0805_2012Metric_61F451E7.CATPart, C3_CP_Elec_5x53_61F4F693.CATPart, C4_C_0603_1608Metric_61F44353.CATPart, C5_C_0603_1608Metric_61F44364.CATPart, J1_pxc_1751303_04_MKDS-1-8-3-5_3D_61F44380.CATPart, LED-UP1-6x24V_Case_assembly_001.CATProduct, LED-UP1-6x24V_Case_bot_001.CATPart]
2022-10-12 STL files for case 001
    [LED-UP1-6x24V_Case_bot_001.stl, LED-UP1-6x24V_Case_bot_001_panel2x3.stl, LED-UP1-6x24V_Case_top_001.stl, LED-UP1-6x24V_Case_top_001_panel2x3.stl]
2023-12-05 moved data from gitlab repo
    [KUPS-DIM-6CVLED-B_Cu.gbr, KUPS-DIM-6CVLED-B_Mask.gbr, KUPS-DIM-6CVLED-B_Paste.gbr, KUPS-DIM-6CVLED-B_SilkS.gbr, KUPS-DIM-6CVLED-Edge_Cuts.gbr, KUPS-DIM-6CVLED-F_Cu.gbr, KUPS-DIM-6CVLED-F_Mask.gbr, KUPS-DIM-6CVLED-F_Paste.gbr]
2024-03-29 New LED-UP1-4x24V
