OpenKNX/LED-UP1-6x24V/(notices)

Notices in the files:
konnekting_software/build_DIM-6CVLED01/sketch/PCA9685.cpp:
This program is free software: you can redistribute it and/or modify
it under the terms of the GNU General Public License as published by
the Free Software Foundation, either version 3 of the License, or
(at your option) any later version.
